mlauke/smartswitch/README.md

# Sonnen SmartSwitch
DIY sonnen battery controller based on ESP8266/ESP32 to drive a 3.3kW heater (Heißwasserspeicher-Einbauheizung) and integrates with the local hot water system.

## Features
- accesses the local hot water system (boiler system) via **LPB** to get the hot water system data - e.g. hot water temparature
- calculate battery capacity and surplus from **solar forecast** to optimize the self consumption
- local web interface to customize system parameters

## UI
<a href="public/ui_full.png">
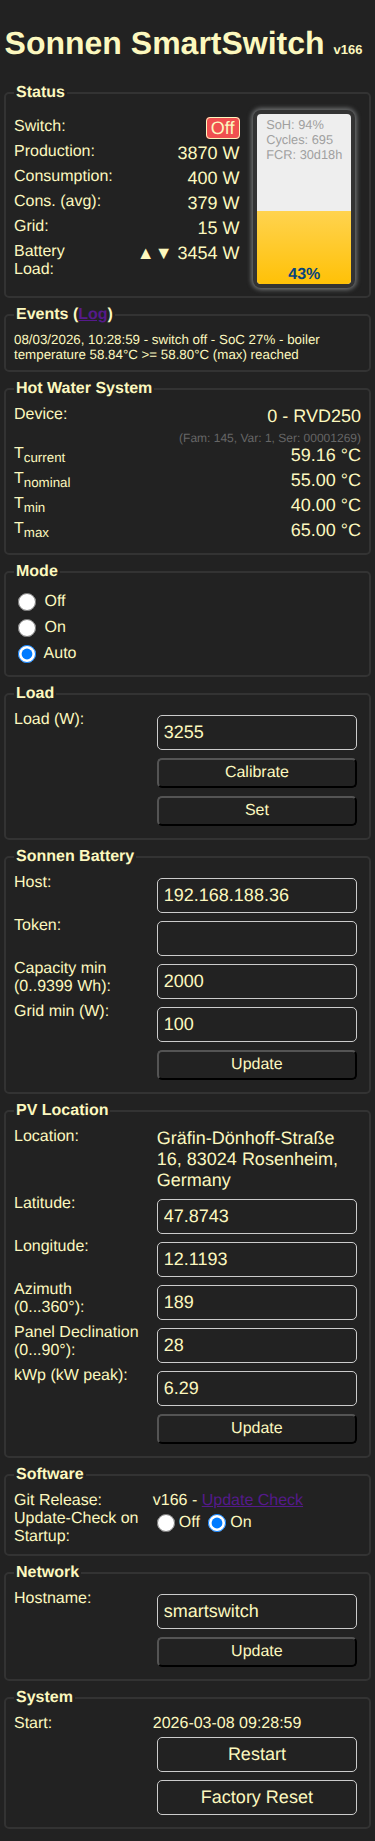
[picture p1: public/ui_full.png]
Sonnen SmartSwitch UI, best viewed in dark mode

</a>

## Software / Releases
the software supports ESP8266 and ESP32 modules, which can be build for the appropriate target platform. releases can be found at https://github.com/mlauke/smartswitch/releases/

### Build
Install uv (https://docs.astral.sh/uv/concepts/tools/) and run proceed to source folder
```bash
cd smartswitch.espxx
# run tests
uv run pio test -e native
# run build
uv run pio run -e esp32 -e esp8266
# run check for outdated packages
uv run pio pkg outdated
```

## Hardware
the reference implementation (at my home) uses the following components
- Heater - https://www.austria-email.at/produkte/zubehoer/elektro-einbauheizung/reu-18-33/
- Hot Water Tank - https://www.austria-email.at/produkte/indirekt-beheizte-speicher/standspeicher/standspeicher-hr/hr-160/
- Sonnen Battery https://sonnen.de/stromspeicher/sonnenbatterie-10/
- Boiler System - Siemens RVD250 attached and connected to the ESP controller via the Local Process Bus (LPB)
- ESP8266/ESP32 controller modules
- ArduiBox housing https://www.az-delivery.de/en/products/arduibox-nodemcu-hutschienen-montage-und-anschluss-set
- DIN Rail Power supply +12V
- AC mains Triac cicuit to drive a 1NO Relay
- 1NO Relay (Schütz) https://www.reichelt.de/de/de/shop/produkt/schaltrelais_1_s_230_v_ac_16_a-155592

### Schematics

The schematics and pcb is drawn with KiCad. The pcb uses a special layout which exactly matches the usable part of the ArduiBox's circuit board. KiCad files can be found <a href="kicad/">here.</a>

<p align="center">
<a href="public/sch.png">
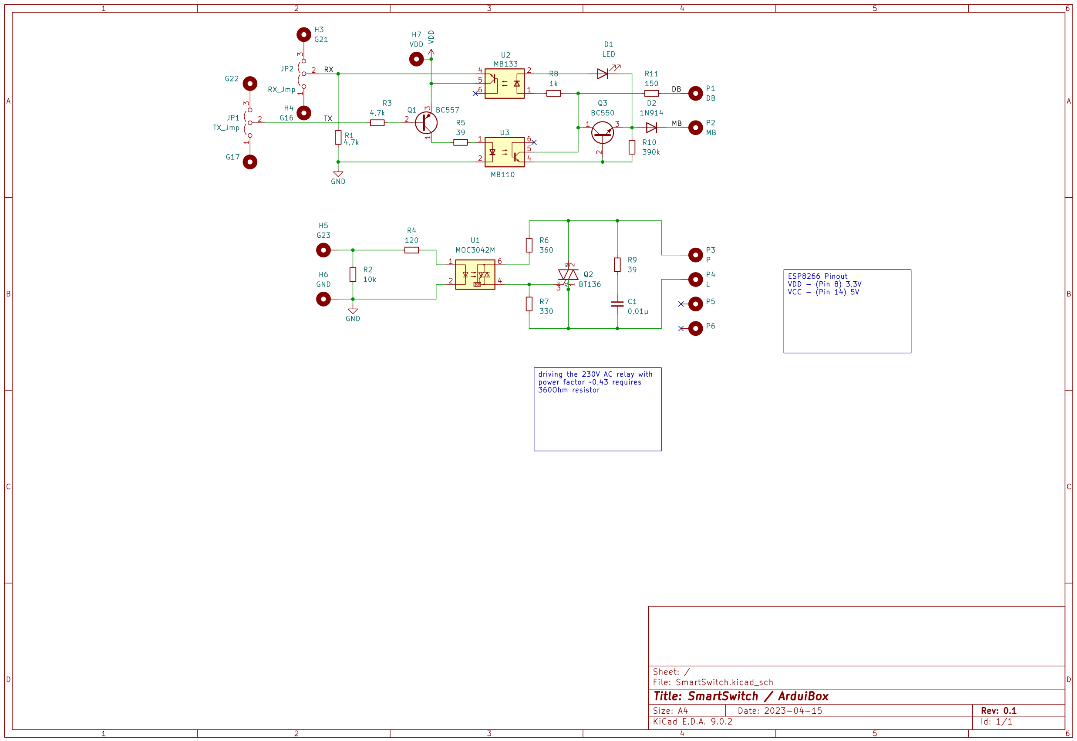
[picture p2: public/sch.png]

</a>
<a href="public/pcb_3d.png">
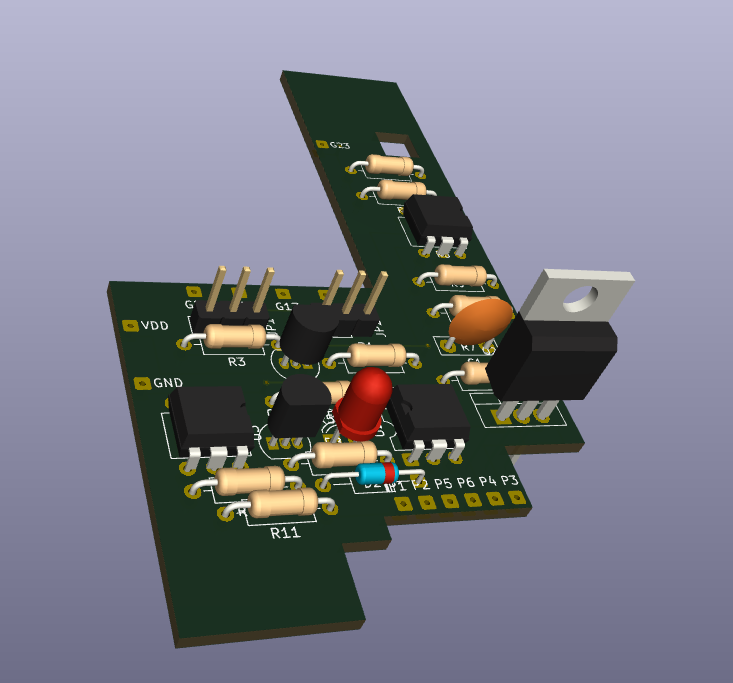
[picture p3: public/pcb_3d.png]

</a>
</p>

### Housing

<details open align="center">
<summary>Housing</summary>
<a href="public/sss_arduibox.png">
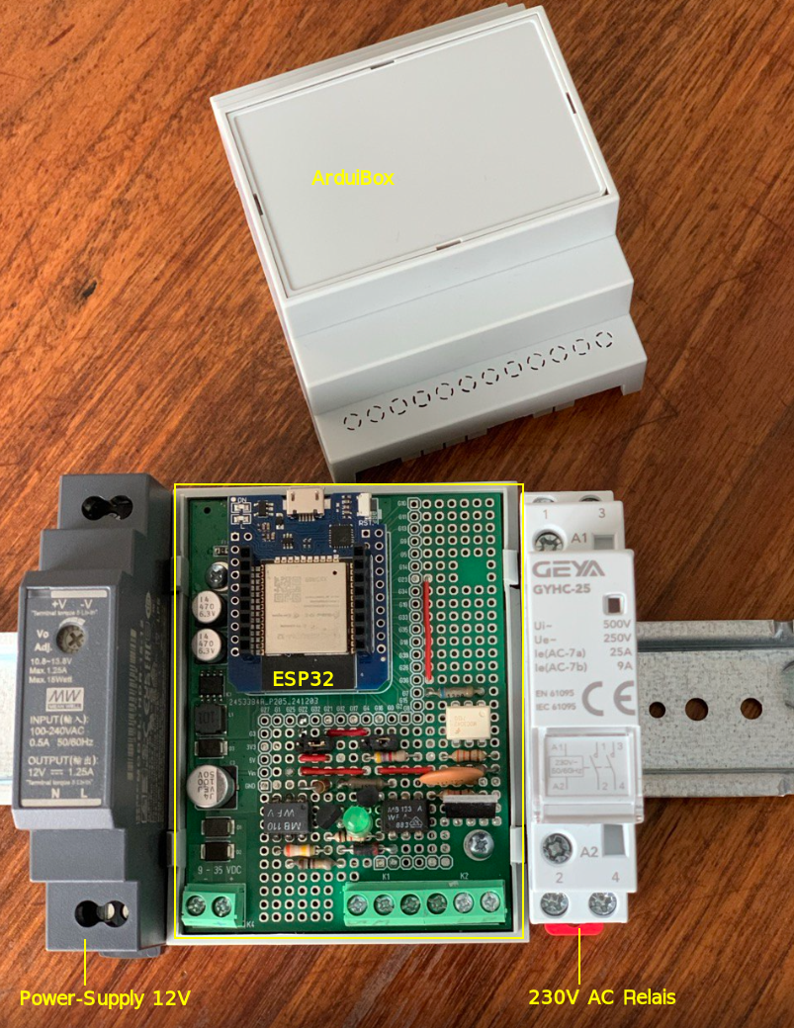
[picture p4: public/sss_arduibox.png]
Sonnen SmartSwitch wihin ArduiBox, Power Supply and Relais (Schütz) mounted on DIN rail

</a>
<!--a href="public/sss_fusebox_big.png">
<img alt="Sonnen SmartSwitch installed in fuse box" src="public/sss_fusebox_big.png" width="30%"/-->
<a href="public/sss_fusebox.png">
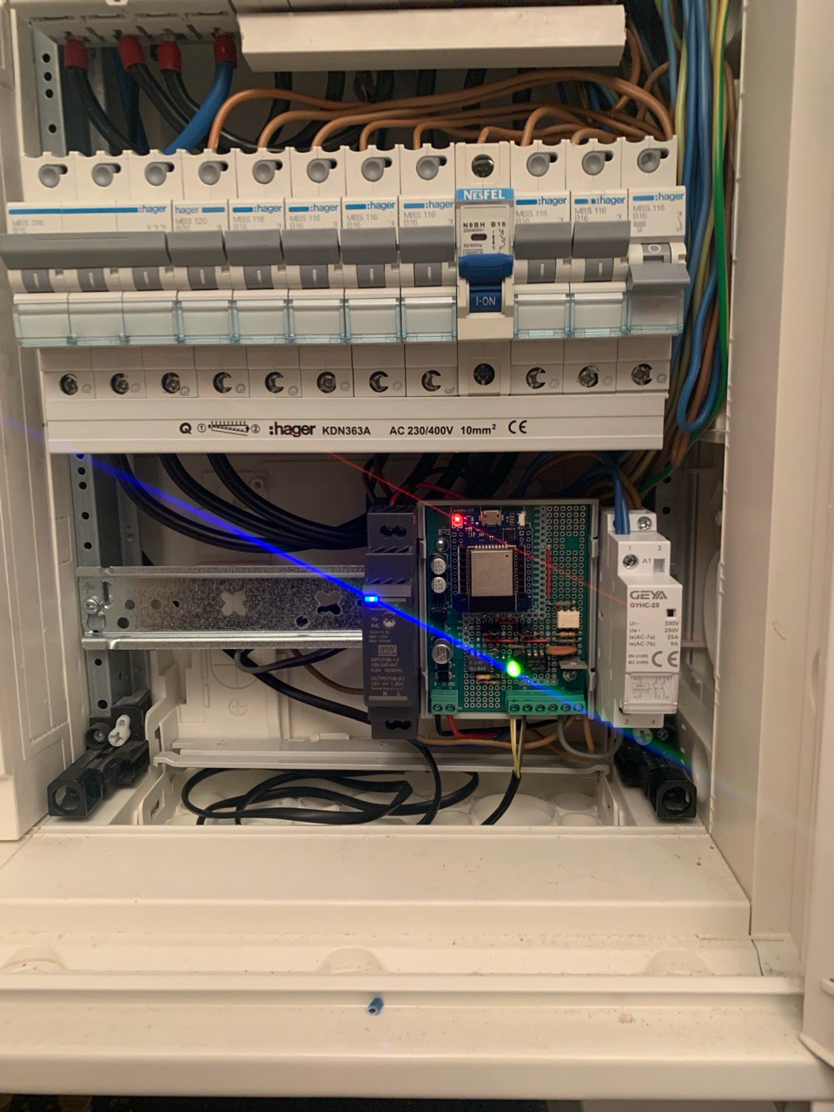
[picture p5: public/sss_fusebox.png]
Sonnen SmartSwitch installed in fuse box

</a>
</details>

### Thoughts
#### Why not using a TRIAC only solution?
Although Triacs have very low Rs_on values in nowadays, they become very hot depending on the load to drive. Using a 3.3kW heater will require a big heatsink as can be seen in the calculation below.

```bash
Pmax = (Tj,max - Tamb,max) / Rth

I = P / U = 3300W / 230 V = 14,35A
Rs_on (BTA25) = 0,16 Ohm
P_loss = U * I = Rs_on * I * I
P_loss = 0,16 Ohm * (14,35 A)²
P_loss = 32,95W

R_max = (T_max - T_env) / P_loss
R_max = (120°C - 40°C) / 33W
R_max = 2,42K/W
R_heatsink = R_max - R_jc = 2,42K/W - 1,7K/W
R_heatsink = 0,7K/W !!!
```

... heatsink with <=0,7K/W makes no sense, because we will waste too much power wasted just for heating the environment and maybe would "blow up" the overall system design in terms of size and housing the components.
therefore i decided to use a triac as switching device for a simple NO1 relais ("Schütz") which in turn will drive the load. the NO1 relais can directly placed next to the arduino case on our din rail.

#### Why not using a SSR?
as mentioned above, a SSR which can drive the 3,3kW load will become very hot if the load is switched on for longer heating periods. too hot to put the SSR together with the ESP controller board on a din rail inside of my houses fuse box.

## Vision
- hardware
  - build a GaN (HEMT) AC Power Converter to dynamically control the "waste" of surplus power based on a bidirection GaN (HEMT) device => https://www.infineon.com/products/power/gallium-nitride/gan-bidirectional-switches/high-voltage-gan-bidirectional-switches e.g. https://www.infineon.com/part/IGLT65R055B2
