mlauke/smartswitch/public/sss_fusebox_big.png

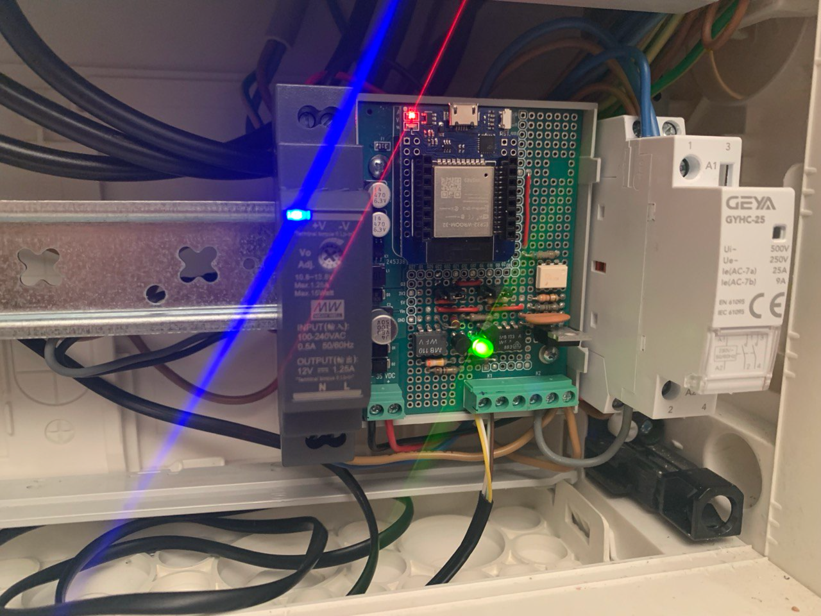
public/sss_fusebox_big.png
