mlauke/smartswitch/public/ui_top.png

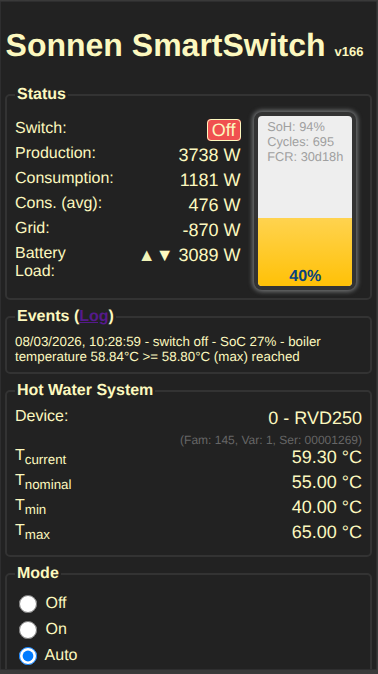
public/ui_top.png
