mlauke/smartswitch/ltspice/LPB_Adapter.asc

D1: diode
D2: LED
Q1: npn; BC547C
Q2: pnp; BC557C
R1: res; 39
R2: res; 4.7k
R3: res; 1k
R5: res; 390k
R7: res; 4.7k
R8: res; 150
U2: PC817A
U4: PC817A
V1: voltage; PULSE(3.3 0 0.05 0 0 0.005 0.02 20)
V2: voltage; 15.5
V3: voltage; 3.3V
Named nets: 0, TX, RX, VCC, DB, MB
.tran 0 200m 0 10u
