mlauke/smartswitch/kicad/SmartSwitch.kicad_pcb

## KiCad design kicad/SmartSwitch.kicad_pcb (2026-03-17)

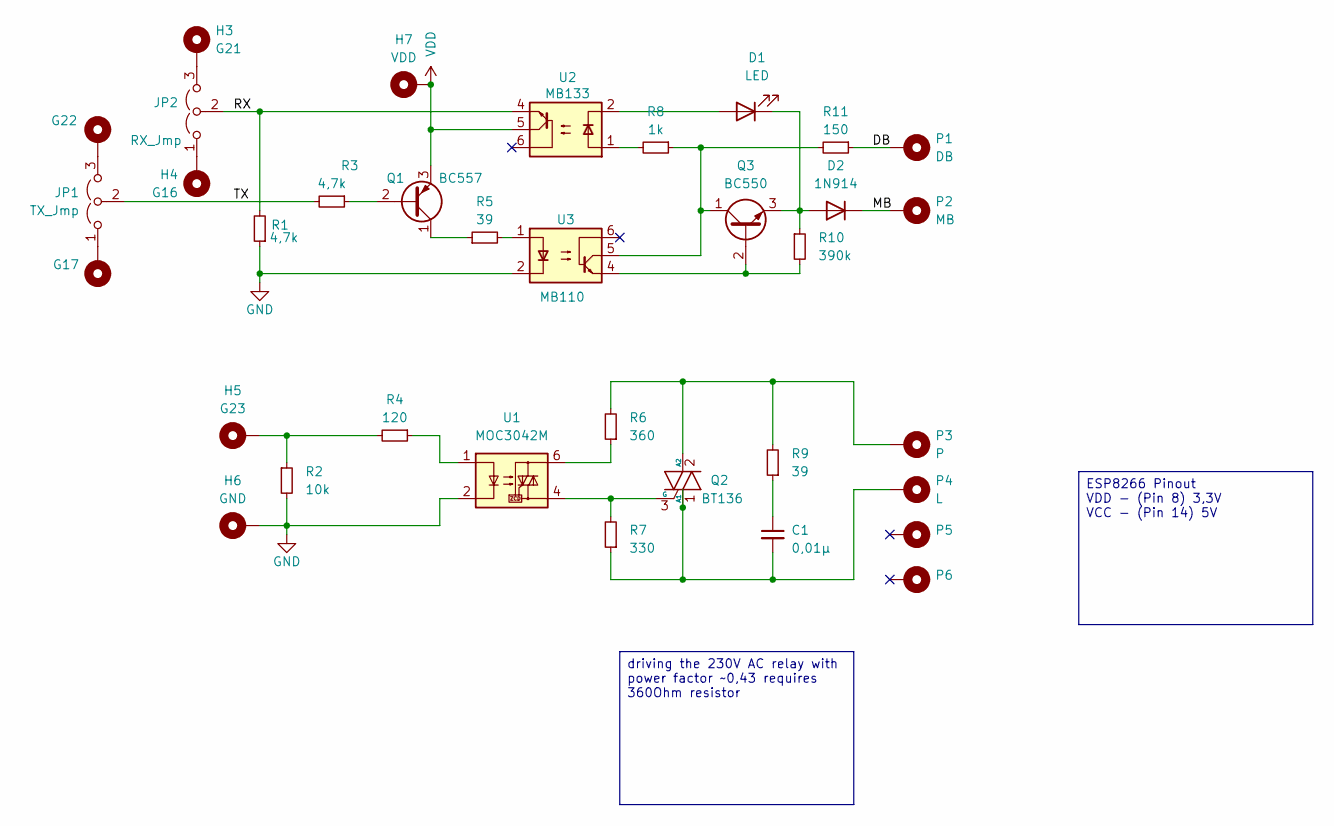
[picture p8: schematic SmartSwitch.kicad_sch, SmartSwitch / ArduiBox]

Parts:
C1: 0,01µ; C_Disc_D7.5mm_W2.5mm_P5.00mm
D1: LED; LED_D4.0mm
D2: 1N914; D_DO-35_SOD27_P10.16mm_Horizontal
H1: G22; SolderWire-0.1sqmm_1x01_D0.4mm_OD1mm
H2: G17; SolderWire-0.1sqmm_1x01_D0.4mm_OD1mm
H3: G21; SolderWire-0.1sqmm_1x01_D0.4mm_OD1mm
H4: G16; SolderWire-0.1sqmm_1x01_D0.4mm_OD1mm
H5: G23; SolderWire-0.1sqmm_1x01_D0.4mm_OD1mm
H6: GND; SolderWire-0.1sqmm_1x01_D0.4mm_OD1mm
H7: VDD; SolderWire-0.1sqmm_1x01_D0.4mm_OD1mm
JP1: TX_Jmp; PinHeader_1x03_P2.54mm_Vertical
JP2: RX_Jmp; PinHeader_1x03_P2.54mm_Vertical
P1: DB; SolderWire-0.1sqmm_1x01_D0.4mm_OD1mm
P2: MB; SolderWire-0.1sqmm_1x01_D0.4mm_OD1mm
P3: P; SolderWire-0.1sqmm_1x01_D0.4mm_OD1mm
P4: L; SolderWire-0.1sqmm_1x01_D0.4mm_OD1mm
P5, P6: SolderWire-0.1sqmm_1x01_D0.4mm_OD1mm
Q1: BC557; TO-92_Inline
Q2: BT136; TO-220-3_Vertical
Q3: BC550; TO-92_Inline
R1, R3: 4,7k; R_Axial_DIN0207_L6.3mm_D2.5mm_P10.16mm_Horizontal
R2: 10k; R_Axial_DIN0207_L6.3mm_D2.5mm_P10.16mm_Horizontal
R4: 120; R_Axial_DIN0207_L6.3mm_D2.5mm_P10.16mm_Horizontal
R5, R9: 39; R_Axial_DIN0207_L6.3mm_D2.5mm_P10.16mm_Horizontal
R6: 360; R_Axial_DIN0207_L6.3mm_D2.5mm_P10.16mm_Horizontal
R7: 330; R_Axial_DIN0207_L6.3mm_D2.5mm_P10.16mm_Horizontal
R8: 1k; R_Axial_DIN0207_L6.3mm_D2.5mm_P10.16mm_Horizontal
R10: 390k; R_Axial_DIN0207_L6.3mm_D2.5mm_P10.16mm_Horizontal
R11: 150; R_Axial_DIN0207_L6.3mm_D2.5mm_P10.16mm_Horizontal
U1: MOC3042M; DIP-6_W7.62mm
U2: MB133; DIP-6_W7.62mm
U3: MB110; DIP-6_W7.62mm

Connections:
/DB: P1.1, R11.1
/MB: D2.1 (K), P2.1
/RX: JP2.2 (C), R1.2, U2.4
/TX: JP1.2 (C), R3.2
GND: H6.1, R1.1, R2.2, U1.2, U3.2
unnamed: C1.1, R9.1
unnamed: D1.2 (A), U2.2
unnamed: D1.1 (K), D2.2 (A), Q3.3 (E), R10.1
unnamed: H5.1, R2.1, R4.2
unnamed: H2.1, JP1.1 (A)
unnamed: H1.1, JP1.3 (B)
unnamed: H4.1, JP2.1 (A)
unnamed: H3.1, JP2.3 (B)
unnamed: Q1.2 (B), R3.1
unnamed: Q1.1 (C), R5.1
unnamed: C1.2, P4.1, Q2.1 (A1), R7.1
unnamed: P3.1, Q2.2 (A2), R6.2, R9.2
unnamed: Q2.3 (G), R7.2, U1.4
unnamed: Q3.2 (B), R10.2, U3.4
unnamed: Q3.1 (C), R8.1, R11.2, U3.5
unnamed: R4.1, U1.1
unnamed: R5.2, U3.1
unnamed: R6.1, U1.6
unnamed: R8.2, U2.1
VDD: H7.1, Q1.3 (E), U2.5

Notes on the sheet:
ESP8266 Pinout VDD - (Pin 8) 3,3V VCC - (Pin 14) 5V
driving the 230V AC relay with power factor ~0,43 requires 360Ohm resistor

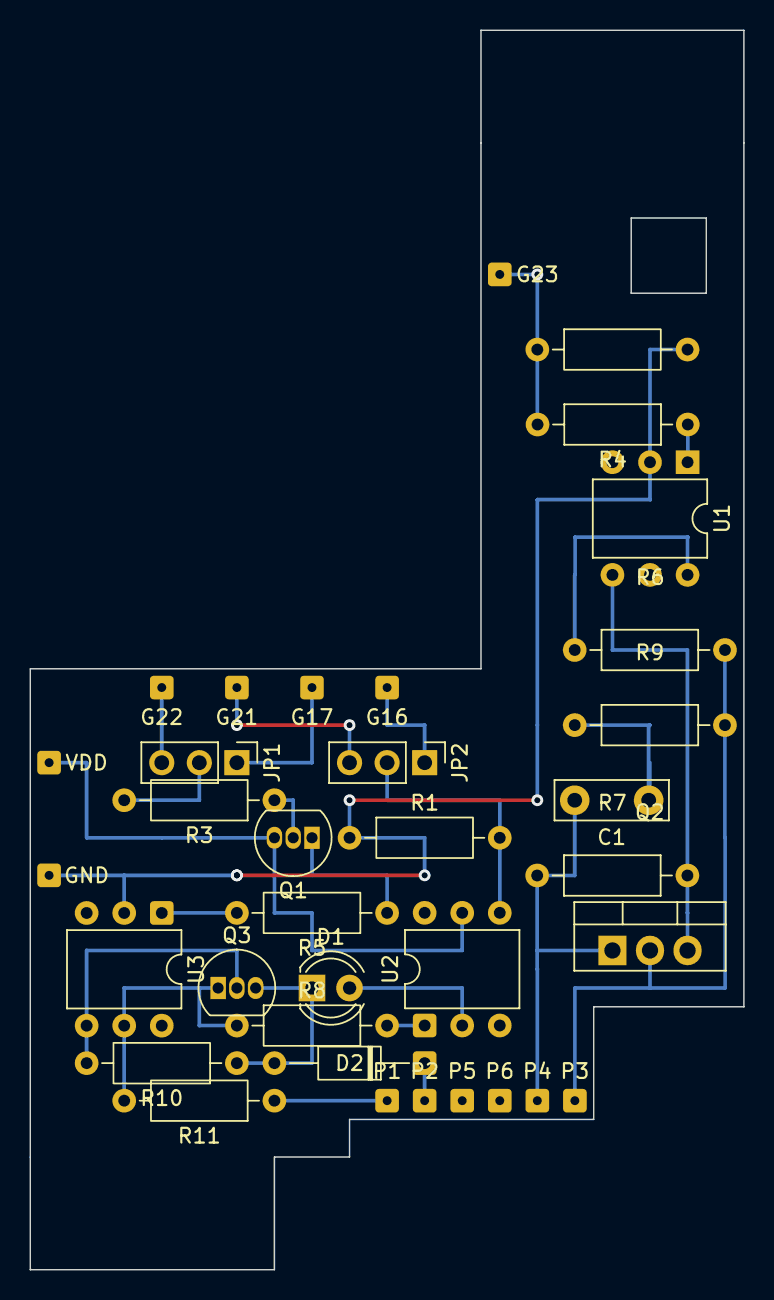
[picture p9: board SmartSwitch.kicad_pcb from above]

Board: 2 copper layers, 48.3 x 83.8 mm, 35 parts (0 on the bottom side), 25 nets.
