mlauke/smartswitch/smartswitch.espxx/src/main.ino

// MIT License
//
// Copyright (c) 2024 Marko Lauke
//
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
// THE SOFTWARE IS PROVIDED "AS IS", WITHOUT WARRANTY OF ANY KIND, EXPRESS OR
// IMPLIED, INCLUDING BUT NOT LIMITED TO THE WARRANTIES OF MERCHANTABILITY,
// FITNESS FOR A PARTICULAR PURPOSE AND NONINFRINGEMENT. IN NO EVENT SHALL THE
// AUTHORS OR COPYRIGHT HOLDERS BE LIABLE FOR ANY CLAIM, DAMAGES OR OTHER
// LIABILITY, WHETHER IN AN ACTION OF CONTRACT, TORT OR OTHERWISE, ARISING FROM,
// OUT OF OR IN CONNECTION WITH THE SOFTWARE OR THE USE OR OTHER DEALINGS IN THE
// SOFTWARE.
#include <Arduino.h>
#include <ArduinoJson.h>
#include <LittleFS.h>
#include <Ticker.h>
#include <WiFiClient.h>
#include <WiFiClientSecure.h>
#include <WiFiManager.h>

// echo -e "const char index_html[] PROGMEM = { $(gzip -9 -c nginx/index.html | hexdump -v -e '1/1 "0x%02X, "') };" > src/smartswitch.esp8266/index_html.h && \
// echo -e "const char app_js[] PROGMEM = { $(gzip -9 -c nginx/app.js | hexdump -v -e '1/1 "0x%02X, "') };" > src/smartswitch.esp8266/app_js.h && \
// echo "const char app_css[] PROGMEM = { $(gzip -9 -c nginx/app.css | hexdump -v -e '1/1 "0x%02X, "') };" > src/smartswitch.esp8266/app_css.h

#include "GithubOTA.h"
#include "RestClient.h"
#include "JsonFields.h"
#include "SonnenApi.h"
#include "LPB.h"
#include "Util.h"

#include "app_js.h"
#include "app_css.h"
#include "app_icon.h"
#include "index_html.h"

#ifdef ESP32
#include <ESPmDNS.h>
#include <WiFi.h>
#include <WebServer.h>
#include <esp_task_wdt.h>
#include <freertos/FreeRTOS.h>
#include <freertos/task.h>

#elif ESP8266
#include <ESP8266HTTPClient.h>
#include <ESP8266WiFi.h>
#include <ESP8266WebServer.h>
#include <ESP8266mDNS.h>
#include <ESP8266httpUpdate.h>
#endif

#include "SmartSwitch.h"
#include "Logic.h"
#include "debug.h"

#ifdef ESP32
static WebServer server(WEBSERVER_PORT);
#elif ESP8266
static ESP8266WebServer server(WEBSERVER_PORT);
#endif

volatile bool doUpdateFlag = false;

LPB *lpb;
WiFiManager wifiManager;
Ticker timer;
SystemState systemState;
SystemConfig config;
bool saveConfigFile = false;
static SwitchStateId currentState = STATE_OFF;

void saveConfigCallback()
{
  saveConfigFile = true;
}

// labels and the pointer array both in flash - on esp8266 plain .rodata would land in dram
static const char PHASE_LABEL_SERVER[] PROGMEM = "web server";
static const char PHASE_LABEL_CYCLE[] PROGMEM = "update cycle";
static const char PHASE_LABEL_WIFI[] PROGMEM = "wifi reconnect";
static const char PHASE_LABEL_BATTERY[] PROGMEM = "battery api";
static const char PHASE_LABEL_FORECAST[] PROGMEM = "pv forecast";
static const char PHASE_LABEL_BOILER[] PROGMEM = "boiler transfer";
static const char PHASE_LABEL_UPDATE[] PROGMEM = "update check";

static const char *const WatchdogPhaseLabel[PHASE_COUNT] PROGMEM = {
    NULL, PHASE_LABEL_SERVER, PHASE_LABEL_CYCLE, PHASE_LABEL_WIFI,
    PHASE_LABEL_BATTERY, PHASE_LABEL_FORECAST, PHASE_LABEL_BOILER, PHASE_LABEL_UPDATE};

// survives watchdog, panic and external reset - only a power loss clears it, hence the magic
static RESET_PERSIST_ATTR uint32_t watchdogPhaseMagic;
static RESET_PERSIST_ATTR uint8_t watchdogPhase;

// every remote call may block until its timeout, so the watchdog is fed before each of them.
// the phase is kept in memory that survives a reset, so a reboot can name what was blocking
static void feedWatchdog(WatchdogPhase phase)
{
  watchdogPhaseMagic = WATCHDOG_PHASE_MAGIC;
  watchdogPhase = phase;

#ifdef ESP32
  esp_task_wdt_reset();
#elif ESP8266
  ESP.wdtFeed();
#endif
}

// names the phase the reset hit, empty if the marker did not survive or the restart was planned
static String lastWatchdogPhase()
{
  if (watchdogPhaseMagic != WATCHDOG_PHASE_MAGIC || watchdogPhase == PHASE_IDLE || watchdogPhase >= PHASE_COUNT)
  {
    return String();
  }
  return String(F(" (")) + FPSTR((const char *)pgm_read_ptr(&WatchdogPhaseLabel[watchdogPhase])) + F(")");
}

void start()
{
  server.begin(); // Actually start the server
  DEBUGLN("HTTP server started");

  uint8_t retries = isDevMode() ? 1 : LPB_RETRIES;
  if (!lpb->enableInterface(retries))
  {
    putBoilerError(String("LPB: No device found after ") + retries + " retries!");
  }
#ifdef ESP32
  esp_task_wdt_init(WDT_TIMEOUT_S, true); // panic handler reboots, the ssr input is high-z until setup() drives it
  esp_task_wdt_add(NULL);                 // watch the task running loop()
#elif ESP8266
  ESP.wdtEnable(20000);
#endif
}

// the reset reason survives in hardware, it is the only trace a watchdog or panic leaves
static String resetReason()
{
#ifdef ESP32
  switch (esp_reset_reason())
  {
  case ESP_RST_POWERON:
    return F("power on");
  case ESP_RST_EXT:
    return F("external reset");
  case ESP_RST_SW:
    return F("software restart");
  case ESP_RST_PANIC:
    return F("panic / exception");
  case ESP_RST_INT_WDT:
    return F("interrupt watchdog timeout");
  case ESP_RST_TASK_WDT:
    return F("task watchdog timeout");
  case ESP_RST_WDT:
    return F("watchdog timeout");
  case ESP_RST_BROWNOUT:
    return F("brownout");
  default:
    return F("unknown");
  }
#elif defined(ESP8266)
  return ESP.getResetReason();
#endif
}

static void configureSystemTime()
{
  configTime(0, 0, NTP_SERVER_PRIMARY, NTP_SERVER_SECONDARY);
  DEBUGLN("systime configured.");
}

// tls certificate validation rejects every certificate while the clock is still at
// 1970, so the update check must not run before ntp has answered
static void waitForSystemTime()
{
  for (uint16_t waited = 0; waited < NTP_SYNC_TIMEOUT_MS && time(NULL) < NTP_SYNC_EPOCH; waited += NTP_SYNC_POLL_MS)
  {
    delay(NTP_SYNC_POLL_MS);
  }
  DEBUGF("systime: %s\n", toDate((uint32_t)time(NULL)));
}

void setup()
{
  configDefaults();
  systemDefaults();

  Serial.begin(SERIAL_BAUDRATE);

  pinMode(LED_BUILTIN, OUTPUT);
  pinMode(PIN_SSR, OUTPUT);
  updateSwitch(false);

  wifiManager.setSaveConfigCallback(saveConfigCallback);

  WiFiManagerParameter custom_hostname("hostname", "Hostname", config.hostname, CFG_SZ_HOSTNAME);
  wifiManager.addParameter(&custom_hostname);
  wifiManager.setConfigPortalTimeout(60);
  if (!wifiManager.autoConnect("SmartSwitchAP"))
  {
    DEBUGLN("Failed to connect, restarting...");
    restart();
  }

  lpb = new LPB(PIN_LPB_RX, PIN_LPB_TX, LPB_ADDR_SELF, LPB_ADDR_DEST);

  DEBUGLN("Mounting FS...");
  if (!LittleFS.begin())
  {
    DEBUGLN("Failed to mount FS. Attempting to format...");
    LittleFS.format();
    DEBUGLN(" done.");
  }
  if (!loadConfig())
  {
    DEBUGLN("Error loading config");
    saveConfig();
  }

  currentState = stateForMode(config.mode);

  if (saveConfigFile)
  {
    String lcHostname = String(custom_hostname.getValue());
    lcHostname.toLowerCase();
    setConfigStr(config, hostname, lcHostname.c_str());
    if (!saveConfig())
    {
      DEBUGLN("Error saving config");
    }
  }

  WiFi.setHostname(config.hostname);
  MDNS.begin(config.hostname);

  timer.attach_ms(SYSTEM_UPDATE_INTERVAL_MS, timerCallback);

  configureSystemTime();
  waitForSystemTime(); // a valid clock before the first entry is written

  loadEventLogIndex();
  putEvent(String(F("boot: ")) + resetReason() + lastWatchdogPhase());
  feedWatchdog(PHASE_IDLE); // consumed, the next reset starts from a clean marker

  if (config.update_startup)
  {
    handleGithubUpdate();
  }

  updateLocation();

  server.on("/", handleRoot);
  server.on("/favicon.ico", handleFavicon);
  server.on("/app.js", handleAppJs);
  server.on("/app.css", handleAppCss);
  server.on("/api/status", handleStatus);
  server.on("/api/data", handleData);
  server.on("/api/update", handleAPI);
  server.onNotFound(handleNotFound);
#if ESP8266
  server.keepAlive(false);
#endif
  start();

  /* HTTP Server auf Core 0 */
  // xTaskCreatePinnedToCore(
  //     httpTask,
  //     "HTTP",
  //     8192,
  //     NULL,
  //     1,
  //     NULL,
  //     0);
}

void timerCallback()
{
  doUpdateFlag = true;
}

void onOTABegin()
{
  server.close();

  if (timer.active())
    timer.detach();
  lpb->disableInterface();
#ifdef ESP32
  esp_task_wdt_delete(NULL); // flashing keeps loop() busy far longer than the watchdog allows
#elif ESP8266
  ESP.wdtDisable();
#endif
  updateSwitch(false);
}

void onOTAEnd(bool success)
{
  if (success)
  {
    DEBUGLN("OTA update finished successfully!");
    return;
  }
  DEBUGLN("There was an error during OTA update!");
  start(); // restart server again
}

void systemDefaults()
{
  systemState.start_ts = 0;
  systemState.pv_forecast_ts = 0;
  memset(systemState.pv_forecast_ts_wh, 0, sizeof(systemState.pv_forecast_ts_wh));
  systemState.inv_max_w = -1;
  systemState.utc_offset = -1;
  systemState.switchEnabled = false;
  systemState.skipUpdateCountSysten = 0;
}

void configDefaults()
{ // init config struct with default values

#ifdef ESP32
  setConfigStr(config, hostname, WiFi.getHostname());
#elif ESP8266
  setConfigStr(config, hostname, WiFi.hostname().c_str());
#endif
  setConfigStr(config, release_tag, RELEASE_TAG);
  config.sonnenHostname[0] = '\0';
  config.sonnenApiToken[0] = '\0';
  config.lon = 0.0;
  config.lat = 0.0;
  config.az = 0;    // default azimuth to 0 (south)
  config.dec = 30;  // default panel declination
  config.kWp = 1.0; // default kWp
  setConfigStr(config, tz, "Europe/Berlin");
  config.location[0] = '\0';
  config.loadPower_W = 1000; // initial assume 1kW
  config.bat_soc_min = 5;
  config.gridMin_W = GRID_PURCHASE_THRESHOLD_W;
  config.mode = SMODE_OFF; // initial set to off
  config.update_startup = false;

  config.version = 0;
}

static bool isDevMode()
{
  return strstr(config.hostname, "-dev") != NULL;
}

bool updateSolarForecast()
{
  static bool lastResult = false;

  long ms = millis();
  if (config.lat != 0.0 && config.lon != 0.0 && (systemState.pv_forecast_ts == 0 || (systemState.pv_forecast_ts + SOLAR_FORECAST_INTERVAL_MS) < ms))
  {

    RestClient restClient;
    JsonDocument json;

    String solarUrl = isDevMode() ? URL_SOLAR_FORECAST_DEV : URL_SOLAR_FORECAST;
    char url[160];
    // solar forecast api requires azimuth with -180 north, -90 east, 0 south, 90 west
    snprintf(url, sizeof(url), solarUrl.c_str(), config.lat, config.lon, config.dec, config.az - 180, config.kWp);

    feedWatchdog(PHASE_FORECAST);
    if ((lastResult = restClient.get(String(url), json, NULL)))
    {
      serializeJsonPretty(json, Serial);
      memset(systemState.pv_forecast_ts_wh, 0, sizeof(systemState.pv_forecast_ts_wh));
      uint8_t i = 0;
      for (JsonPair entry : json[F("result")].as<JsonObject>())
      {
        uint32_t ts = strtoul(entry.key().c_str(), NULL, 10);
        uint32_t wh = entry.value().as<uint32_t>();
        if (i < SOLAR_FORECAST_HOURS)
        {
          systemState.pv_forecast_ts_wh[i][0] = ts;
          systemState.pv_forecast_ts_wh[i][1] = wh;
          i++;
        }
        else
        {
          putEvent(String(F("WARN: updateSolarForecast overflow ")) + i);
          break;
        }
      }
      setConfigStr(config, location, json[F("message")][F("info")][F("place")].as<const char *>());

      clearLocationError();
    }
    else
    {
      putLocationError(String(F("WARN solar forecast ")) + restClient.lastError());
    }
    systemState.pv_forecast_ts = restClient.lastResponseCode() > 0 ? ms : 0;
  }
  return lastResult;
}

void updateLocation()
{
  if (config.lat == 0.0 && config.lon == 0.0)
  {
    RestClient restClient;
    JsonDocument json;

    if ((saveConfigFile = restClient.get(URL_LOCATION, json, NULL)))
    {
      config.lon = json[F("lon")].as<double>();
      config.lat = json[F("lat")].as<double>();
      snprintf_P(config.location, CFG_SZ_LOCATION, PSTR("%s %s"), json[F("zip")].as<const char *>(), json[F("city")].as<const char *>());
      setConfigStr(config, tz, json[F("timezone")]);
      DEBUGF("Location: %f/%f - tz: %s loc: %s\n", config.lon, config.lat, config.tz, config.location);
    }
  }
}

void cacheControlHeader(bool cache)
{
  if (cache)
    server.sendHeader(F("cache-control"), F("max-age=31536000, must-revalidate"));
  else
    server.sendHeader(F("cache-control"), F("no-cache"));
}

void commonHeader()
{
  server.sendHeader(F("content-encoding"), F("gzip"));
  cacheControlHeader(true);
}

void handleFavicon()
{
  cacheControlHeader(true);
  server.send_P(200, PSTR("image/x-icon"), app_icon, sizeof(app_icon));
}

void handleAppJs()
{
  commonHeader();
  server.send_P(200, PSTR("text/javascript"), app_js, sizeof(app_js));
}

void handleAppCss()
{
  commonHeader();
  server.send_P(200, PSTR("text/css;charset=utf-8"), app_css, sizeof(app_css));
}

void handleRoot()
{
  commonHeader();
  server.send_P(200, PSTR("text/html;charset=utf-8"), index_html, sizeof(index_html));
}

void jsonToConfig(JsonDocument &json)
{
  config.mode = (SwitchMode)json[F("mode")].as<uint8_t>();
  setConfigStr(config, release_tag, json[F("release_tag")]);

  config.update_startup = json[F("update_startup")];

  setConfigStr(config, hostname, json[F("hostname")]);

  setConfigStr(config, sonnenHostname, json[F("sn_host")]);
  setConfigStr(config, sonnenApiToken, json[F("sn_token")]);
  config.gridMin_W = json[F("sn_grdmin")].as<uint16_t>();
  config.loadPower_W = json[F("sn_loadpower")].as<uint16_t>();
  config.bat_soc_min = json[F("sn_soc_min")].as<uint8_t>();

  config.lon = json[F("lc_lon")].as<float>();
  config.lat = json[F("lc_lat")].as<float>();
  config.kWp = json[F("lc_kWp")].as<float>();
  config.az = json[F("lc_az")].as<uint16_t>();
  config.dec = json[F("lc_dec")].as<uint16_t>();

  setConfigStr(config, location, json[F("loc")]);
  setConfigStr(config, tz, json[F("tz")]);

  JsonArray dayStats = json[F("cons_stats")].as<JsonArray>();
  if (!dayStats.isNull())
  {
    for (int d = 0; d < 7 && d < (int)dayStats.size(); d++)
    {
      JsonArray hourStats = dayStats[d].as<JsonArray>();
      for (int h = 0; h < 24 && h < (int)hourStats.size(); h++)
        config.cons_stats_Wh[d][h] = hourStats[h].as<uint16_t>();
    }
  }

  config.version = json[F("version")].as<uint16_t>();
}

void configToJson(JsonDocument &json, bool confidential)
{
  json[F("mode")] = (uint8_t)config.mode;
  json[F("release_tag")] = config.release_tag;

  json[F("update_startup")] = config.update_startup;

  json[F("hostname")] = config.hostname;

  json[F("sn_host")] = config.sonnenHostname;
  if (!confidential)
  {
    json[F("sn_token")] = config.sonnenApiToken;
  }
  json[F("sn_grdmin")] = config.gridMin_W;
  json[F("sn_loadpower")] = config.loadPower_W;
  json[F("sn_soc_min")] = config.bat_soc_min;

  json[F("lc_lon")] = config.lon;
  json[F("lc_lat")] = config.lat;
  json[F("lc_kWp")] = config.kWp;
  json[F("lc_az")] = config.az;
  json[F("lc_dec")] = config.dec;

  json[F("loc")] = config.location;
  json[F("tz")] = config.tz;

  JsonArray dayStats = json[F("cons_stats")].to<JsonArray>();
  for (int d = 0; d < 7; d++)
  {
    JsonArray hourStats = dayStats.add<JsonArray>();
    for (int h = 0; h < 24; h++)
      hourStats.add(config.cons_stats_Wh[d][h]);
  }

  json[F("version")] = config.version;
}

void sendJson(String from, JsonDocument &json)
{
  String jsonString;

  serializeJsonPretty(json, jsonString);
  DEBUGF("%s - json %s\n", from.c_str(), jsonString.c_str());

  cacheControlHeader(false);
  server.send(200, F("application/json"), jsonString);
}

void addLog(JsonArray &array, logEntry &log)
{
  if (strlen(log.msg))
  {
    JsonObject e = array.add<JsonObject>();
    e[F("ts")] = log.ts;
    e[F("msg")] = log.msg;
  }
}

void handleData()
{
  JsonDocument json;

  configToJson(json, true);
  json[F("start_ts")] = toLocalDate(&systemState, systemState.start_ts);
  json[F("ca_store")] = caTrustStoreState();

  JsonArray forecast = json[F("pv_forecast")].to<JsonArray>();
  for (int i = 0; i < SOLAR_FORECAST_HOURS; i++)
  {
    if (systemState.pv_forecast_ts_wh[i][0] == 0)
      break;
    JsonArray entry = forecast.add<JsonArray>();
    entry.add(systemState.pv_forecast_ts_wh[i][0]); // Unix ts (s)
    entry.add(systemState.pv_forecast_ts_wh[i][1]); // Wh
  }

  sendJson("data", json);
}

// api/status
void handleStatus()
{
  JsonDocument json;

  json[F("cons_w")] = systemState.cons_W;
  json[F("cons_avg_w")] = systemState.cons_avg_W;
  json[F("prod")] = systemState.prod_W;
  json[F("grid")] = systemState.gridFeedIn_W;
  json[F("usoc")] = systemState.usoc;
  json[F("chrg")] = systemState.charge;
  json[F("pac_total_w")] = systemState.pac_total_W * -1; // invert - positive means discharge, we invert for display
  json[F("switch")] = systemState.switchEnabled;
  json[F("sn_cap_max")] = systemState.cap_bat_max_Wh;
  json[F("sn_cycles")] = systemState.bat_cycles;
  json[F("sn_cap_soh")] = systemState.cap_bat_soh;
  char buf[16];
  json[F("sn_fchrg_ts")] = format_duration(systemState.fullChargeRequestIn, buf, sizeof(buf));

  char dev_id[40] = "n.a.";
  char dev_nfo[40] = "";
  device_map *device = lpb->getDestDevice();
  if (device != NULL)
  {
    snprintf_P(dev_id, sizeof(dev_id), PSTR("%d - %s"), device->dev_id, device->name);
    snprintf_P(dev_nfo, sizeof(dev_nfo), PSTR("(Fam: %d, Var: %d, Ser: %08X)"), device->dev_fam, device->dev_var, device->dev_serial);
  }
  json[F("bs_dev_id")] = dev_id;
  json[F("bs_dev_nfo")] = dev_nfo;
  json[F("bs_t_cur")] = String(systemState.boiler_T_cur);
  json[F("bs_t_max")] = String(systemState.boiler_T_max);
  json[F("bs_t_min")] = String(systemState.boiler_T_min);
  json[F("bs_t_nom")] = String(systemState.boiler_T_nom);

  JsonArray errors = json[F("errors")].to<JsonArray>();
  addLog(errors, systemState.error_bt);
  addLog(errors, systemState.error_bs);
  addLog(errors, systemState.error_lc);

  JsonArray events = json[F("events")].to<JsonArray>();
  addEventLog(events);

  json[F("version")] = config.version;

  sendJson("status", json);
}

void handleAPI()
{

  bool doRestart = false;

  if (server.hasArg(F("mode")))
  {
    config.mode = (SwitchMode)(server.arg(F("mode")).toInt() & 3);
    currentState = stateForMode(config.mode);
    DEBUGF("Mode: %d\n", config.mode);
    saveConfig();
  }
  else if (server.hasArg(F("calibrate")))
  {
    if (server.arg(F("calibrate")).equals(F("set")))
    {
      config.loadPower_W = MAX(0, server.arg(F("sn_loadpower")).toInt());
      saveConfig();
    }
    else
    {
      currentState = STATE_CALIBRATE;
    }
  }
  else if (server.hasArg(F("update_startup")))
  {
    config.update_startup = server.arg(F("update_startup")).toInt();
    DEBUGF("Enabled: %d\n", config.update_startup);
    saveConfig();
  }
  else if (server.hasArg(F("certs")))
  {
    updateTrustStore(server.hasArg(F("certs_reset")) ? String() : server.arg(F("certs")));
  }
  else if (server.hasArg(F("boiler")))
  {
    // ?
  }
  else if (server.hasArg(F("sonnen")))
  {
    setConfigStr(config, sonnenHostname, server.arg(F("sn_host")).c_str());
    String apiToken = server.arg(F("sn_token"));
    if (apiToken.length() > 0)
    {
      setConfigStr(config, sonnenApiToken, apiToken.c_str());
    }
    config.gridMin_W = MAX(50, MAX(0, server.arg(F("sn_grdmin")).toInt()));
    config.bat_soc_min = MIN(100, MAX(0, server.arg(F("sn_soc_min")).toInt()));
    saveConfig();
    systemState.skipUpdateCountSysten = 0;
  }
  else if (server.hasArg(F("location")))
  {
    config.lon = MAX(0, server.arg(F("lc_lon")).toDouble());
    config.lat = MAX(0, server.arg(F("lc_lat")).toDouble());
    config.kWp = MAX(0, server.arg(F("lc_kWp")).toDouble());
    config.az = MIN(360, MAX(0, server.arg(F("lc_az")).toInt()));
    config.dec = MIN(90, MAX(0, server.arg(F("lc_dec")).toInt()));
    systemState.pv_forecast_ts = 0; // force fetch new data
    setConfigStr(config, location, PSTR("Location will be updated..."));
    for (int d = 0; d < 7; d++)
      for (int h = 0; h < 24; h++)
        config.cons_stats_Wh[d][h] = 0;
    saveConfig();
  }
  else if (server.hasArg(F("hostname")))
  {
    setConfigStr(config, hostname, server.arg(F("hostname")).c_str());
    doRestart = saveConfig();
  }
  else if (server.hasArg(F("restart")))
  {
    doRestart = saveConfig();
  }
  else if (server.hasArg(F("reset")))
  {
    if (server.arg(F("reset")).toInt())
    {
      configDefaults();
      wifiManager.resetSettings(); // reset wifi settings
      doRestart = saveConfig();
    }
  }
  else if (server.hasArg(F("update")))
  {
    handleGithubUpdate();
    return;
  }

  server.sendHeader(F("location"), F("/"));
  server.send(303);
  server.client().flush();

  if (doRestart)
  {
    restart();
  }
}

void handleNotFound()
{
  server.send_P(404, PSTR("text/plain"), PSTR("404: Not found")); // Send HTTP status 404 (Not Found) when there's no handler for the URI in the request
}

void restart()
{
  server.close();
  watchdogPhase = PHASE_IDLE; // an intentional restart has no phase to report
  saveEventLogIndex(); // the stored size matches the file after a controlled restart
  LittleFS.end();
  ESP.restart();
}

String userAgent()
{
  return String(F("SmartSwitch v")) + config.release_tag;
}

const char STRING_HTML_UPDATE[] PROGMEM = "<html lang='en'><head><meta http-equiv='refresh' content='30;url=/'></head><body><h1>%s</h1><p>Redirect in 30s...</p></body></html>";

void sendUpdateStatus(int code, const char *status)
{
  char buffer[256];
  snprintf_P(buffer, sizeof(buffer), STRING_HTML_UPDATE, status);
  server.send(code, F("text/html;charset=utf-8"), buffer);
}

void handleGithubUpdate()
{
  GithubOTA gh_updater(UPDATE_HOST, UPDATE_URL, UPDATE_TYPE, UPDATE_FILENAME);

  feedWatchdog(PHASE_UPDATE); // the download itself unsubscribes the watchdog, see onOTABegin()
  if (!gh_updater.checkUpdate(config.release_tag))
  {
    if (server.client() && server.client().connected())
    {
      char msg[128];
      snprintf_P(msg, sizeof(msg), PSTR("Update failed: %s"), gh_updater.getUpdateStatus().c_str());
      sendUpdateStatus(404, msg);
    }
    return;
  }

  if (server.client() && server.client().connected())
  {
    char msg[128];
    snprintf_P(msg, sizeof(msg), PSTR("Update found: Going to install Release %s."), gh_updater.release_tag.c_str());
    sendUpdateStatus(200, msg);
  }
  if (gh_updater.doUpdate(userAgent(), &onOTABegin, &onOTAEnd))
  {
    setConfigStr(config, release_tag, gh_updater.release_tag.c_str());
    if (!saveConfig())
    {
      putEvent(String(F("error saving config with release tag ")) + gh_updater.release_tag);
    }
    else
    {
      DEBUGLN("config saved.");
      restart();
    }
  }
  else
  {
    putEvent(gh_updater.getUpdateStatus());
  }
}

// replaces the tls trust store used for OTA, empty content restores the firmware bundle
void updateTrustStore(const String &pem)
{
  if (pem.length() == 0)
  {
    resetCaTrustStore();
    putEvent(F("certificates reset to firmware bundle"));
    return;
  }
  const __FlashStringHelper *error = saveCaTrustStore(pem);
  putEvent(error == NULL ? String(F("certificates updated")) : String(F("certificates rejected - ")) + error);
}

void clearLocationError()
{
  systemState.error_lc.msg[0] = '\0';
}

void putLocationError(String event)
{
  putLog(systemState.error_lc, event.c_str());
}

void clearBatteryError()
{
  systemState.error_bt.msg[0] = '\0';
}

void putBatteryError(String event)
{
  putLog(systemState.error_bt, event.c_str());
}

void putBoilerError(String event)
{
  putLog(systemState.error_bs, event.c_str());
}

void clearBoilerError()
{
  systemState.error_bs.msg[0] = '\0';
}

// system time comes from the battery api, ntp fills the gap until the first successful poll
static uint32_t eventTimestamp()
{
  return systemState.ts > 0 ? systemState.ts : (uint32_t)time(NULL);
}

void putLog(logEntry &log, const char *event)
{
  snprintf(log.msg, sizeof(log.msg), "%s", event);
  log.ts = eventTimestamp();
  DEBUGF("log %u: %s\n", log.ts, event);
}

void putEvent(const char *event)
{
  logEntry log;
  putLog(log, event);
  appendEventLog(log);
}

void putEvent(String event)
{
  putEvent(event.c_str());
}

static bool updateBoilerData()
{

  static long long lastUpdateSeconds = 0;
  static long lastResult = false;

  long seconds = millis() / 1000;
  if (lastUpdateSeconds == 0 || seconds > lastUpdateSeconds + BOILER_UPDATE_INTERVAL_SECONDS)
  {
    lastUpdateSeconds = seconds;

    boiler_t boilerData;
    feedWatchdog(PHASE_BOILER); // the whole transfer runs inside the driver, this is the last chance to feed
    if ((lastResult = lpb->update(&boilerData, isDevMode())))
    {
      systemState.boiler_T_cur = boilerData.t_cur;
      systemState.boiler_T_nom = boilerData.t_nom;
      systemState.boiler_T_min = boilerData.t_min;
      systemState.boiler_T_max = boilerData.t_max;

      clearBoilerError();
    }
    else
    {
      putBoilerError(F("Could not update boiler data."));
    }
  }
  return lastResult; // no new data, so still ok
}

// maps the user configured switch mode to the matching runtime state
static SwitchStateId stateForMode(SwitchMode mode)
{
  switch (mode)
  {
  case SMODE_ON:
    return STATE_ON;
  case SMODE_AUTO:
    return STATE_AUTO;
  case SMODE_OFF:
  default:
    return STATE_OFF;
  }
}

static void handleOff(SystemStatus status)
{
  systemState.switchEnabled = false;
}

static void handleOn(SystemStatus status)
{
  systemState.switchEnabled = true;
}

static void handleAuto(SystemStatus status)
{
  char msg[96];
  bool desiredState = determineDesiredState(msg, sizeof(msg), &config, &systemState, status);
  if (systemState.switchEnabled != desiredState)
  {
    putEvent(String(desiredState ? F("on") : F("off")) + F(" - ") + msg);
  }
  systemState.switchEnabled = desiredState;

  DEBUGF("handleAuto() ts: %s (%u) usoc: %2d%% p/c: %d/%d (W) avg: %d (Wh) grid: %d (W) heater %d\n",
         toDate(systemState.ts), systemState.ts, systemState.usoc, systemState.prod_W,
         systemState.cons_W, systemState.cons_avg_W, systemState.gridFeedIn_W, systemState.switchEnabled);
}

static void handleCalibrate(SystemStatus status)
{
  static uint8_t cnt = CALIBRATE_LOOP_CNT;
  static uint16_t load_on[CALIBRATE_MEASURE];
  static uint16_t load_off[CALIBRATE_MEASURE];

  if (status != SystemStatus::Ok)
  {
    putEvent("invalid configuration, cannot calibrate load");
    currentState = stateForMode(config.mode); // back to normal operation
    return;
  }

  if (cnt == 0)
  {
    config.loadPower_W = MAX(0, (median_uint16(load_on, CALIBRATE_MEASURE) - median_uint16(load_off, CALIBRATE_MEASURE)));
    saveConfig();

    char event[64];
    snprintf_P(event, sizeof(event), PSTR("load calibrated, on %dW / off %dW => %dW"), median_uint16(load_on, CALIBRATE_MEASURE), median_uint16(load_off, CALIBRATE_MEASURE), config.loadPower_W);
    putEvent(event);

    memset(load_on, 0, sizeof(load_on));
    memset(load_off, 0, sizeof(load_off));
    cnt = CALIBRATE_LOOP_CNT;

    systemState.switchEnabled = false;
    currentState = stateForMode(config.mode); // done, back to normal operation
  }
  else
  {
    bool on = (--cnt & CALIBRATE_ONOFF_TOGGLE) == 0;
    if ((cnt & CALIBRATE_MEASURE) == 0) // wait with measure after toggle
    {
      if (on)
      {
        load_on[cnt & (CALIBRATE_MEASURE - 1)] = systemState.cons_W;
      }
      else
      {
        load_off[cnt & (CALIBRATE_MEASURE - 1)] = systemState.cons_W;
      }
    }
    systemState.switchEnabled = on;
  }
}

// dispatch table indexed by SwitchStateId ordinal
static const SwitchStateHandler stateHandlers[STATE_COUNT] = {
    handleCalibrate, // [STATE_CALIBRATE]
    handleOn,        // [STATE_ON]
    handleOff,       // [STATE_OFF]
    handleAuto,      // [STATE_AUTO]
};

uint16_t updateSystemCount = 0; // initially do update

bool isUpdateSystemData()
{
  return updateSystemCount == 0;
}

bool updateSystemCounter()
{
  bool isZero = updateSystemCount-- == 0;
  if (isZero)
  {
    updateSystemCount = 4 * 60 * SYSTEM_UPDATE_INTERVAL_MS / 1000; // every 4 hours
  }
  return isZero;
}

static SystemStatus updateSystemStatus()
{
  if (!ensureConnected())
    return SystemStatus::Error_Network;
  if (!updateSystemData())
    return SystemStatus::Error_Battery;
  if (!updateBoilerData())
    return SystemStatus::Error_Boiler;
  return SystemStatus::Ok;
}

// main loop
void loop()
{
  if (doUpdateFlag)
  {
    feedWatchdog(PHASE_CYCLE);

    if (updateSystemCounter() && ensureConnected())
    {
      configureSystemTime();
    }

    SystemStatus status = updateSystemStatus();

    updateSolarForecast();

    stateHandlers[currentState](status);

    updateSwitch(systemState.switchEnabled);

    doUpdateFlag = false;
    feedWatchdog(PHASE_SERVER); // the cycle is done, only server.handleClient() runs from here

    DEBUGF("ESP Heap %uk CPU: %uMhz valid: %d\n", ESP.getFreeHeap() >> 10, ESP.getCpuFreqMHz(), status);
  }
  server.handleClient();
}

void buildInLED(bool onOff)
{
#ifdef ESP32
  digitalWrite(LED_BUILTIN, onOff ? HIGH : LOW);
#else
  digitalWrite(LED_BUILTIN, onOff ? LOW : HIGH);
#endif
}

void statusLED(int status)
{
  int d = 1000 - (100 * (status % 10));
  for (int i = 0; i < status; i++)
  {
    buildInLED(true);
    delay(d);
    buildInLED(false);
    delay(d);
  }
}

static bool ensureConnected()
{
  wl_status_t status = WiFi.status();
  if (status != WL_CONNECTED)
  {
    DEBUG("Connecting");
    for (int retry = 1; retry <= WIFI_RECONNECT_RETRIES; retry++)
    {
      feedWatchdog(PHASE_WIFI);
      statusLED(0);
      DEBUG(".");
      delay(WIFI_RECONNECT_DELAY_MS);

      status = WiFi.status();
      if (status == WL_CONNECTED)
      {
        DEBUGF("Connected. IP address: %s status: %d\n", WiFi.localIP().toString().c_str(), status);
        break;
      }
      else
      {
        DEBUGF("Wifi not connected, status: %d\n", status);
        if (status == WL_IDLE_STATUS)
        {
          WiFi.disconnect();
          status = WiFi.begin();
        }
      }
    }
    if (status != WL_CONNECTED)
    {
      putEvent(String(F("restart: wifi not connected, status ")) + status);
      restart();
    }
  }
  return status == WL_CONNECTED;
}

bool fetchBatteryApi(String uri, JsonDocument &json, const JsonField *expectedFields, uint8_t expectedFieldCount)
{
  return fetchBatteryApi(uri, json, expectedFields, expectedFieldCount, NULL);
}

bool fetchBatteryApi(String uri, JsonDocument &json, const JsonField *expectedFields, uint8_t expectedFieldCount, JsonDocument *filter)
{

  bool r = false;

  RestClient restClient;

  if (strlen(config.sonnenHostname) && strlen(config.sonnenApiToken))
  {
    char url[128];
    snprintf_P(url, sizeof(url), PSTR("http://%.31s/%s/%s"), config.sonnenHostname, SONNEN_API_URI, uri.c_str());
    feedWatchdog(PHASE_BATTERY);
    r = restClient.get(String(url), json, filter, expectedFields, expectedFieldCount, "auth-token", config.sonnenApiToken);
    if (!r)
    {
      DEBUGF("ERROR: fetchBatteryApi(%s)\n", uri.c_str());
      putBatteryError(restClient.lastError());
    }
  }
  else
  {
    putBatteryError(F("Sonnen Battery Hostname/Token not properly configured!"));
  }
  return r;
}

static bool updateSystemData()
{

  static uint8_t errorLoopBackoff = 1;

  JsonDocument json;

  if (systemState.skipUpdateCountSysten > 0)
  {
    systemState.skipUpdateCountSysten--;
    return false;
  }

  bool ok = true;

  if (systemState.inv_max_w == -1)
  {
    if ((ok &= fetchBatteryApi(SONNEN_API_CONFIGURATIONS, json, SONNEN_FIELDS_CONFIGURATIONS, JSON_FIELD_COUNT(SONNEN_FIELDS_CONFIGURATIONS))))
    {
      systemState.inv_max_w = json[FPSTR(KEY_SN_INVERTER_MAX_POWER_W)].as<int>();
      systemState.cap_bat_new_Wh = json[FPSTR(KEY_SN_MODULE_CAPACITY)].as<int>() * json[FPSTR(KEY_SN_BATTERY_MODULES)].as<int>() * 90 / 100;
      DEBUGF("IC_InverterMaxPower_w %d, max battery capacity %d\n", systemState.inv_max_w, systemState.cap_bat_new_Wh);
    }
  }
  if (systemState.cap_bat_max_Wh == 0 || isUpdateSystemData())
  {
    if (ok && (ok &= fetchBatteryApi(SONNEN_API_BATTERY, json, SONNEN_FIELDS_BATTERY, JSON_FIELD_COUNT(SONNEN_FIELDS_BATTERY))))
    {
      systemState.cap_bat_max_Wh = json[FPSTR(KEY_SN_FULL_CHARGE_CAPACITY_WH)].as<uint16_t>();
      systemState.bat_cycles = json[FPSTR(KEY_SN_CYCLE_COUNT)].as<uint16_t>();
      systemState.cap_bat_soh = systemState.cap_bat_new_Wh == 0 ? 0 : systemState.cap_bat_max_Wh * 100 / systemState.cap_bat_new_Wh;
      DEBUGF("FullChargeCapacity %d, cycles: %d, capacity: %2d%%\n", systemState.cap_bat_max_Wh, systemState.bat_cycles, systemState.cap_bat_soh);
    }
  }
  JsonDocument filter;
  filter[FPSTR(KEY_SN_UTC_OFFSET)] = true;
  filter[FPSTR(KEY_SN_IC_STATUS)][FPSTR(KEY_SN_SETPOINT_PRIORITY)][FPSTR(KEY_SN_FULL_CHARGE_REQUEST)] = true;
  filter[FPSTR(KEY_SN_IC_STATUS)][FPSTR(KEY_SN_NEXT_FULL_CHARGE_START)] = true;
  filter[FPSTR(KEY_SN_IC_STATUS)][FPSTR(KEY_SN_SECONDS_SINCE_FULL_CHARGE)] = true;
  if (ok && (ok &= fetchBatteryApi(SONNEN_API_LATEST_DATA, json, SONNEN_FIELDS_LATEST_DATA, JSON_FIELD_COUNT(SONNEN_FIELDS_LATEST_DATA), &filter)))
  {
    systemState.utc_offset = json[FPSTR(KEY_SN_UTC_OFFSET)].as<int16_t>() * 3600;
    systemState.fullChargeRequest = json[FPSTR(KEY_SN_IC_STATUS)][FPSTR(KEY_SN_SETPOINT_PRIORITY)][FPSTR(KEY_SN_FULL_CHARGE_REQUEST)].as<bool>();
    systemState.fullChargeRequestIn =
        json[FPSTR(KEY_SN_IC_STATUS)][FPSTR(KEY_SN_NEXT_FULL_CHARGE_START)].as<uint32_t>() -
        json[FPSTR(KEY_SN_IC_STATUS)][FPSTR(KEY_SN_SECONDS_SINCE_FULL_CHARGE)].as<uint32_t>();

    DEBUGF("UTC offset %d, discharge not allowed: %d %u\n", systemState.utc_offset, systemState.fullChargeRequest, systemState.fullChargeRequestIn);
  }
  if (ok && (ok &= fetchBatteryApi(SONNEN_API_STATUS, json, SONNEN_FIELDS_STATUS, JSON_FIELD_COUNT(SONNEN_FIELDS_STATUS))))
  {
    systemState.usoc = json[FPSTR(KEY_SN_USOC)].as<uint8_t>();
    systemState.cap_bat_Wh = systemState.cap_bat_max_Wh * systemState.usoc / 100;
    systemState.gridFeedIn_W = json[FPSTR(KEY_SN_GRID_FEED_IN_W)].as<int>();
    systemState.prod_W = json[FPSTR(KEY_SN_PRODUCTION_W)].as<uint16_t>();
    systemState.cons_W = json[FPSTR(KEY_SN_CONSUMPTION_W)].as<uint16_t>();
    systemState.pac_total_W = json[FPSTR(KEY_SN_PAC_TOTAL_W)].as<int16_t>();
    systemState.charge = json[FPSTR(KEY_SN_BATTERY_CHARGING)].as<short>() - json[FPSTR(KEY_SN_BATTERY_DISCHARGING)].as<short>();

    struct tm time;
    strptime(json[FPSTR(KEY_SN_TIMESTAMP)].as<const char *>(), "%Y-%m-%d %H:%M:%S", &time);

    systemState.ts = mktime(&time) - systemState.utc_offset; // to UTC
    if (systemState.start_ts == 0)
    {
      systemState.start_ts = systemState.ts;
    }

    int16_t prev_stat_key = systemState.stat_hour_key;
    updateSystemState(&config, &systemState);
    if (systemState.stat_hour_key != prev_stat_key && prev_stat_key != -1)
    {
      saveConfig();
    }
  }

  if (ok && !(ok &= (config.loadPower_W > 0)))
  {
    // TODO wrong error category
    putBatteryError("Load not properly configured! Must be > 0!");
  }

  if (ok)
  {
    clearBatteryError();
    errorLoopBackoff = 1; // reset backoff
  }
  else
  {
    systemState.skipUpdateCountSysten = errorLoopBackoff; // error loop back off
    if (errorLoopBackoff != (1 << 7))
    {
      errorLoopBackoff <<= 1;
    }
  }

  return ok;
}

static void updateSwitch(bool switchEnabled)
{
  digitalWrite(PIN_SSR, switchEnabled ? HIGH : LOW);
  buildInLED(switchEnabled);
}

static uint8_t logSegment = 0; // active segment 0..LOG_SEGMENTS - 1
static uint32_t logSize = 0;   // payload of the active segment, tracked in ram

static String logSegmentPath(uint8_t segment)
{
  char path[24];
  snprintf_P(path, sizeof(path), PSTR(LOGFILE_PATTERN), segment);
  return String(path);
}

// remembers the active segment across restarts, size is the payload as of the last save
static bool saveEventLogIndex()
{
  File f = LittleFS.open(LOGFILE_INDEX, "w");
  if (!f)
  {
    DEBUGF("Could not open log index %s for writing\n", LOGFILE_INDEX);
    return false;
  }

  JsonDocument json;
  json[F("current")] = logSegment;
  json[F("size")] = logSize;
  serializeJson(json, f);
  f.close();
  return true;
}

// restores the active segment and closes an entry that a power loss cut in half
static void loadEventLogIndex()
{
  File index = LittleFS.open(LOGFILE_INDEX, "r");
  if (index)
  {
    JsonDocument json;
    if (deserializeJson(json, index) == DeserializationError::Ok)
    {
      logSegment = json[F("current")].as<uint8_t>() % LOG_SEGMENTS;
    }
    index.close();
  }

  String path = logSegmentPath(logSegment);
  bool unterminated = false;

  if (LittleFS.exists(path)) // missing before the very first entry is written
  {
    File segment = LittleFS.open(path, "r");
    logSize = segment.size();
    if (logSize > 0)
    {
      segment.seek(logSize - 1);
      unterminated = segment.read() != '\n';
    }
    segment.close();
  }

  if (unterminated) // terminate the torn entry, it is dropped later because it does not parse
  {
    File f = LittleFS.open(path, "a");
    if (f)
    {
      f.write('\n');
      f.close();
      logSize++;
    }
  }
  DEBUGF("event log segment %u, %u bytes\n", logSegment, logSize);
}

// starts the next segment, emptying it keeps "payload == file size" true for every segment
static void rotateEventLog()
{
  logSegment = (logSegment + 1) % LOG_SEGMENTS;
  logSize = 0;

  File f = LittleFS.open(logSegmentPath(logSegment), "w"); // drops the previous generation
  if (f)
  {
    f.close();
  }
  saveEventLogIndex();
}

// one json line per entry, an entry is never split across two segments
static void appendEventLog(const logEntry &log)
{
  JsonDocument json;
  json[F("ts")] = log.ts;
  json[F("msg")] = log.msg;
  size_t len = measureJson(json) + 1; // plus the record separator

  if (logSize + len > LOG_SEGMENT_MAX_SIZE)
  {
    rotateEventLog();
  }

  File f = LittleFS.open(logSegmentPath(logSegment), "a");
  if (!f)
  {
    DEBUGF("Could not open log segment %u for writing\n", logSegment);
    return;
  }
  serializeJson(json, f);
  f.write('\n');
  f.close();
  logSize += len;
}

// collects the youngest entries of one segment, newest first
static void addEventLogSegment(JsonArray &array, uint8_t segment)
{
  File f = LittleFS.open(logSegmentPath(segment), "r");
  if (!f)
  {
    return;
  }

  uint32_t offsets[LOG_VIEW_ENTRIES];
  uint16_t count = 0;

  if (f.size() > LOG_VIEW_TAIL_SIZE)
  {
    f.seek(f.size() - LOG_VIEW_TAIL_SIZE);
    f.readStringUntil('\n'); // the jump lands inside an entry, drop its remainder
  }
  while (f.available())
  {
    offsets[count++ % LOG_VIEW_ENTRIES] = f.position();
    f.readStringUntil('\n');
  }

  uint16_t entries = MIN(count, (uint16_t)LOG_VIEW_ENTRIES);
  for (uint16_t i = 1; i <= entries && array.size() < LOG_VIEW_ENTRIES; i++)
  {
    f.seek(offsets[(count - i) % LOG_VIEW_ENTRIES]);

    JsonDocument entry;
    if (deserializeJson(entry, f.readStringUntil('\n')) != DeserializationError::Ok)
    {
      continue; // torn or corrupted entry
    }
    JsonObject e = array.add<JsonObject>();
    e[F("ts")] = entry[F("ts")].as<uint32_t>();
    e[F("msg")] = entry[F("msg")].as<String>(); // as String, so the text is copied
  }
  f.close();
}

// hands the youngest entries to the ui, walking the segment ring backwards
static void addEventLog(JsonArray &array)
{
  uint8_t segment = logSegment;
  for (uint8_t i = 0; i < LOG_SEGMENTS && array.size() < LOG_VIEW_ENTRIES; i++)
  {
    if (!LittleFS.exists(logSegmentPath(segment)))
    {
      break; // the ring has not wrapped around yet, there is no older history
    }
    addEventLogSegment(array, segment);
    segment = (segment + LOG_SEGMENTS - 1) % LOG_SEGMENTS;
  }
}

static bool loadConfig()
{
  if (!LittleFS.exists(CONFIGFILE))
  {
    DEBUGLN("Config file not found");

    return false;
  }

  File f = LittleFS.open(CONFIGFILE, "r");
  if (!f)
  {
    DEBUGF("Could not open config file %s\n", CONFIGFILE);

    return false;
  }

  JsonDocument json;
  DeserializationError error = deserializeJson(json, f);
  f.close();

  if (error)
  {
    return false;
  }

  DEBUGLN("Config loaded:");
  serializeJsonPretty(json, Serial);

  jsonToConfig(json);

  return true;
}

static bool saveConfig(bool updateVersion)
{
  File f = LittleFS.open(CONFIGFILE, "w");
  if (!f)
  {
    DEBUGF("Could not open config file %s for writing\n", CONFIGFILE);
    return false;
  }

  if (updateVersion)
    config.version++; // update version

  JsonDocument json;
  configToJson(json, false);
  DEBUGLN("saveConfig() => ");
  serializeJsonPretty(json, Serial);
  serializeJson(json, f);
  f.close();
  saveConfigFile = false;
  return true;
}

static bool saveConfig()
{
  return saveConfig(true);
}
