mlauke/smartswitch/smartswitch.espxx/include/SmartSwitch.h

// MIT License
//
// Copyright (c) 2024 Marko Lauke
//
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
#ifndef SMARTSWITCH_H
#define SMARTSWITCH_H

#include <stdint.h>

#ifdef ESP32
#define PIN_LPB_TX GPIO_NUM_17
#define PIN_LPB_RX GPIO_NUM_16
#define PIN_SSR GPIO_NUM_23

#elif ESP8266
#define LED_BUILTIN 2
#define PIN_LPB_TX 5 // GPIO5 (D1)
#define PIN_LPB_RX 4 // GPIO4 (D2)
#define PIN_SSR 13   // GPIO13 (D7)
#endif

#define HOSTNAME "smartswitch"
#define RELEASE_TAG "-"
#define CONFIGFILE "/config.json"

#define SERIAL_BAUDRATE 115200
#define WEBSERVER_PORT 80

#define NTP_SERVER_PRIMARY "pool.ntp.org"
#define NTP_SERVER_SECONDARY "time.nist.gov"
#define NTP_SYNC_TIMEOUT_MS 5000
#define NTP_SYNC_POLL_MS 250
#define NTP_SYNC_EPOCH 1700000000 // Nov 2023 - anything below means the clock is unset

#define LPB_BAUDRATE 4800
#define LPB_ADDR_SELF 2
#define LPB_ADDR_DEST 0
#define LPB_RETRIES 5

#define WIFI_RECONNECT_RETRIES 8
#define WIFI_RECONNECT_DELAY_MS 500

// the watchdog is fed between the blocking calls (feedWatchdog() in main.ino), so it only has to
// cover the longest single phase: one rest request, or the boiler transfer which runs as one block.
// derived from REQUEST_TIMEOUT (RestClient.h) and the LPB timings (LPB.h), so the watchdog follows
// automatically when one of those timeouts is changed
#define LPB_UPDATE_TIMEOUT_MS (LPB_QUERIES_PER_UPDATE * QUERY_RETRIES * (LPB_BUS_FREE_TIMEOUT_MS + LPB_REPLY_TIMEOUT_MS))
#define SYSTEM_UPDATE_TIMEOUT_MS MAX(REQUEST_TIMEOUT, LPB_UPDATE_TIMEOUT_MS)

#define WDT_RESERVE_MS 10000 // headroom for everything that is not a remote call
#define WDT_TIMEOUT_S ((SYSTEM_UPDATE_TIMEOUT_MS + WDT_RESERVE_MS) / 1000)

#define SYSTEM_UPDATE_INTERVAL_MS 2000 // update intervall millis
#define SYSTEM_ON_COUNT MAX(1, (10000 + (SYSTEM_UPDATE_INTERVAL_MS >> 1)) / SYSTEM_UPDATE_INTERVAL_MS)

#define SONNEN_API_URI "api/v2"
#define SONNEN_API_CONFIGURATIONS "configurations"
#define SONNEN_API_LATEST_DATA "latestdata"
#define SONNEN_API_BATTERY "battery"
#define SONNEN_API_STATUS "status"
#define SONNEN_INVERTER_LATENCY_MS 5000 // battery inverter latency until load is compensated - sonnen battery 10 specific
#define SONNEN_INVERTER_LATENCY_COUNT (1 + (SONNEN_INVERTER_LATENCY_MS + (SYSTEM_UPDATE_INTERVAL_MS >> 1)) / SYSTEM_UPDATE_INTERVAL_MS)

#define URL_LOCATION "http://ip-api.com/json/"

#define SOLAR_FORECAST_INTERVAL_MS (12 * 60 * 1000) // update intervall every 12min
#define SOLAR_FORECAST_HOURS 49                     // 49h
#define SOLAR_FORECAST_SAFETY_FACTOR 0.95f
#define URL_SOLAR_FORECAST "http://api.forecast.solar/estimate/watthours/period/%.4f/%.4f/%d/%d/%.2f?time=seconds&no_sun=0&full=1"
#define URL_SOLAR_FORECAST_DEV "http://192.168.188.20:8080/estimate/watthours/period/%.4f/%.4f/%d/%d/%.2f?time=seconds&no_sun=0&full=1"

#define GRID_PURCHASE_THRESHOLD_W 100
#define BATTERY_USOC_OFF 3
#define BATTERY_USOC_ON 10

#define BOILER_TEMPERATURE_HYSTERESIS 2
#define BOILER_AFTERGLOW_K_PER_KW 0.5f // heater afterglow rises with load power: 1 kW -> 0.5 °C
#define BOILER_BOOST_REMAINING_PCT 65  // below this share of today's yield the pv day is running out
#define BOILER_UPDATE_INTERVAL_SECONDS 15

#define CFG_SZ_HOSTNAME 32
#define CFG_SZ_REL_TAG 5
#define CFG_SZ_SONNENHOST 32
#define CFG_SZ_SONNENTOKEN 37
#define CFG_SZ_LOCATION 64
#define CFG_SZ_TZ 32
#define SZ_LOG_ENTRY 256

#define CALIBRATE_LOOP_CNT (1 << 5)
#define CALIBRATE_ONOFF_TOGGLE (CALIBRATE_LOOP_CNT >> 1)
#define CALIBRATE_MEASURE (CALIBRATE_ONOFF_TOGGLE >> 1)
#define CALIBRATE_AVG_DIV (CALIBRATE_LOOP_CNT / CALIBRATE_ONOFF_TOGGLE / 2 * CALIBRATE_MEASURE)

#define LOGFILE_INDEX "/eventlog.json"
#define LOGFILE_PATTERN "/eventlog-%02u.log"
#define LOG_SEGMENTS 4
#define LOG_SEGMENT_MAX_SIZE (16 * 1024)
#define LOG_VIEW_ENTRIES 16     // entries handed to the ui
#define LOG_VIEW_TAIL_SIZE 4096 // bytes scanned back from a segment's end to find them

#define MIN(a, b) ((a) < (b) ? (a) : (b))
#define MAX(a, b) ((a) > (b) ? (a) : (b))

#define _cs(a) sizeof(((SystemConfig *)0)->a)
#define setConfigStr(cfg, property, str)                          \
  {                                                               \
    const char *tmp = str;                                        \
    if (tmp && *tmp)                                              \
    {                                                             \
      snprintf_P((cfg).property, _cs(property), PSTR("%s"), tmp); \
    }                                                             \
  }

enum SystemStatus
{
  Ok,
  Error_Network,
  Error_Battery,
  Error_Boiler
};

static const char *SystemStatusLabel[4]{
    "Ok",
    "Network",
    "Battery",
    "Boiler"};

enum SwitchMode
{
  SMODE_OFF,
  SMODE_ON,
  SMODE_AUTO
};

// runtime states of the load switch state machine, dispatched by ordinal
enum SwitchStateId
{
  STATE_CALIBRATE,
  STATE_ON,
  STATE_OFF,
  STATE_AUTO,
  STATE_COUNT // sentinel: number of states / handler table size
};

// phase of the update cycle, kept across a reset so a watchdog reboot can name what was blocking
enum WatchdogPhase
{
  PHASE_IDLE, // nothing to report, set on an intentional restart
  PHASE_SERVER,
  PHASE_CYCLE,
  PHASE_WIFI,
  PHASE_BATTERY,
  PHASE_FORECAST,
  PHASE_BOILER,
  PHASE_UPDATE,
  PHASE_COUNT // sentinel: number of phases / label table size
};

#define WATCHDOG_PHASE_MAGIC 0x5750484Aul // marks the phase as written by this firmware

#ifdef ESP32
#define RESET_PERSIST_ATTR RTC_NOINIT_ATTR // dram can be clobbered by the bootloader, rtc memory cannot
#elif ESP8266
#define RESET_PERSIST_ATTR __attribute__((section(".noinit")))
#else
#define RESET_PERSIST_ATTR
#endif

typedef void (*SwitchStateHandler)(SystemStatus status);
typedef struct
{

  char hostname[CFG_SZ_HOSTNAME];
  char release_tag[CFG_SZ_REL_TAG];
  char sonnenHostname[CFG_SZ_SONNENHOST];
  char sonnenApiToken[CFG_SZ_SONNENTOKEN];

  uint16_t loadPower_W;
  uint8_t bat_soc_min; // battery min capacity as SoC (0..100%) - custom min capacity
  uint16_t gridMin_W;
  float lat;
  float lon;
  float kWp;   // installed PV power
  uint8_t dec; // PV panel declination (0..90°)
  uint16_t az; // PV panel Azimuth 0..360°
  char location[CFG_SZ_LOCATION];
  char tz[CFG_SZ_TZ + 1];
  enum SwitchMode mode;          // 0 - off, 1 - on, 2 - automatic
  bool update_startup;           // release update check on startup
  uint16_t cons_stats_Wh[7][24]; // avg consumption per weekday (0=Sun) x hour (Watt), true hourly mean blended via cross-week EMA α=0.1
  uint16_t version;              //
} SystemConfig;

typedef struct
{
  uint32_t ts;
  char msg[SZ_LOG_ENTRY];
} logEntry;

typedef struct
{
  uint32_t start_ts;  // system start timestamp
  uint32_t ts;        // current system timestamp in seconds (UTC) - taken from battery status
  int16_t utc_offset; // UTC to local time offset in seconds
  bool switchEnabled; // state of the load switch

  float boiler_T_cur;
  float boiler_T_nom;
  float boiler_T_min;
  float boiler_T_max;

  int16_t inv_max_w;            // inverter power max - max charge/discharge power
  uint8_t usoc;                 // 0..100 user state of charge - battery capacity in %
  uint16_t system_Power_W;      // production + battery inverter max power (Watt) if battery usoc is >0
  uint16_t prod_W;              // current PV production (Watt)
  uint16_t cons_W;              // current consumption (Watt)
  uint16_t cons_W_nom;          // consumption rounded as multiple of 10 (Watt)
  uint16_t cons_W_norm;         // normalized consumption without load (Watt)
  uint16_t cons_avg_W;          // consumption average (W) - long term mean over hours, used to build statistics
  uint16_t bat_cycles;          // Number of charge/discharge cycles
  uint16_t cap_bat_new_Wh;      // max usable battery capacity for new battery
  uint8_t cap_bat_soh;          // percentage of usable battery capacity (SoH)
  uint16_t cap_bat_Wh;          // current capacity
  uint16_t cap_bat_max_Wh;      // max battery capacity (system)
  int16_t pac_total_W;          // inverter ac power -   AC Power greater than ZERO is discharging Inverter AC Power less than ZERO is charging
  int16_t gridFeedIn_W;         // current grid feed in - negative is consumption, positive is feed in
  bool fullChargeRequest;       // e.g. true during battery maintenance
  uint32_t fullChargeRequestIn; // next full charge request starts in given seconds
  int8_t charge;                // battery charge state 0 - none, 1 - charge, -1 - discharge

  long pv_forecast_ts;                                 // last update timestamp in ms since mcu start
  uint32_t pv_forecast_ts_wh[SOLAR_FORECAST_HOURS][2]; // pair of timestamp and pv production (Wh/h) for 48h (today and tomorrow)

  uint8_t skipUpdateCountSysten; // skip update on error count

  logEntry error_bs; // last boiler system error
  logEntry error_bt; // last battery error
  logEntry error_lc; // last solar forecast or location error
  uint8_t errorIx = 0;

  int16_t stat_hour_key = -1; // weekday*24+hour key of last stats update, -1 = uninitialized

  uint32_t cons_sum_W = 0; // running sum of cons_W_norm within current hour
  uint16_t cons_count = 0; // number of samples accumulated in current hour

} SystemState;

#endif
