mlauke/smartswitch/smartswitch.espxx/include/app_css.h

const char app_css[] PROGMEM = { 0x1F, 0x8B, 0x08, 0x08, 0x8F, 0x14, 0x8B, 0x6A, 0x02, 0x03, 0x61, 0x70, 0x70, 0x2E, 0x63, 0x73, 0x73, 0x00, 0xAD, 0x59, 0xDB, 0x6E, 0xE3, 0x36, 0x10, 0x7D, 0xDF, 0xAF, 0x10, 0x12, 0x04, 0x88, 0x01, 0xD3, 0x90, 0x65, 0xCB, 0x71, 0x1C, 0x6C, 0xB1, 0xBD, 0x60, 0xD1, 0x87, 0x02, 0x7D, 0x6D, 0xB1, 0xE8, 0x03, 0x2D, 0x51, 0x36, 0x1B, 0x4A, 0x14, 0x48, 0x3A, 0x4E, 0xB6, 0xD8, 0x7F, 0xEF, 0xF0, 0x26, 0x51, 0xB4, 0x94, 0x4D, 0x8A, 0xC6, 0x0B, 0x47, 0xA1, 0xC8, 0xE1, 0xCC, 0x99, 0x99, 0x33, 0x43, 0xEE, 0x82, 0x3F, 0x11, 0xC1, 0xF0, 0x4B, 0xF2, 0xCF, 0x87, 0x24, 0x69, 0xB9, 0xA4, 0x8A, 0xF2, 0x66, 0x97, 0x54, 0xF4, 0x99, 0x94, 0x0F, 0x30, 0xA4, 0x78, 0xBB, 0x4B, 0x52, 0xFD, 0xC4, 0x48, 0xA5, 0xDC, 0xE3, 0x9E, 0x3F, 0x23, 0x49, 0xBF, 0xD2, 0xE6, 0xB0, 0x83, 0x67, 0x51, 0x12, 0x81, 0x60, 0x48, 0xBF, 0xA9, 0x69, 0x83, 0xCE, 0xB4, 0x54, 0xC7, 0x5D, 0xB2, 0x4C, 0xD3, 0x1B, 0x3D, 0x54, 0x52, 0xD9, 0xC2, 0x06, 0x20, 0x93, 0x11, 0x33, 0x47, 0xFF, 0x46, 0x25, 0x15, 0xA4, 0xB0, 0x7B, 0x15, 0x9C, 0x9D, 0xEA, 0x46, 0xBF, 0xC1, 0x8C, 0x1E, 0x1A, 0x44, 0x15, 0xA9, 0xE5, 0x2E, 0x91, 0x0A, 0x0B, 0x65, 0x76, 0xC3, 0xC5, 0xE3, 0x41, 0xF0, 0x53, 0x53, 0xEE, 0x12, 0x71, 0xD8, 0xE3, 0xDB, 0x74, 0x9E, 0xB8, 0x7F, 0x8B, 0xBB, 0x99, 0x9E, 0xF1, 0x44, 0x25, 0xDD, 0x53, 0x46, 0x15, 0xEC, 0x72, 0xA4, 0x65, 0x49, 0x8C, 0x34, 0x25, 0x70, 0xE3, 0xED, 0xE1, 0x2D, 0x2E, 0xE0, 0x35, 0xAC, 0x58, 0xC9, 0x84, 0x60, 0x49, 0xE6, 0xC1, 0xA2, 0x7E, 0xD4, 0x1A, 0xA7, 0x0D, 0x02, 0xFD, 0xDB, 0xE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
9, 0x96, 0x02, 0x5E, 0xB9, 0xC1, 0x6C, 0xDD, 0x17, 0xB3, 0x80, 0x7F, 0xE7, 0x5E, 0x9C, 0x47, 0x28, 0xE8, 0x18, 0x31, 0x1E, 0xAE, 0x88, 0x8A, 0xC5, 0x77, 0x6C, 0xB9, 0xA0, 0xA2, 0x0B, 0xC9, 0xC3, 0x5C, 0x47, 0x03, 0x1E, 0x37, 0x85, 0xF3, 0x5F, 0xDE, 0x82, 0x95, 0xA9, 0xA7, 0x1A, 0x00, 0x00,  };
