mlauke/smartswitch/smartswitch.espxx/include/index_html.h

const char index_html[] PROGMEM = { 0x1F, 0x8B, 0x08, 0x08, 0x4C, 0x15, 0x8B, 0x6A, 0x02, 0x03, 0x69, 0x6E, 0x64, 0x65, 0x78, 0x2E, 0x68, 0x74, 0x6D, 0x6C, 0x00, 0xC5, 0x5A, 0xDB, 0x72, 0xE3, 0x36, 0x12, 0x7D, 0xF7, 0x57, 0x20, 0xDC, 0x9A, 0x1A, 0xB9, 0x2A, 0xB2, 0x64, 0x4F, 0x32, 0x49, 0xA6, 0x24, 0x4E, 0xD9, 0x1A, 0xCF, 0xA5, 0x6A, 0x2E, 0x2E, 0xCB, 0x59, 0x27, 0x4F, 0x2A, 0x88, 0x84, 0x44, 0x44, 0x10, 0xC0, 0x02, 0x40, 0xC9, 0x9A, 0x0F, 0xD9, 0xEF, 0x48, 0xED, 0x73, 0x9E, 0xF2, 0x29, 0xFB, 0x25, 0xDB, 0x00, 0xC1, 0x9B, 0x44, 0x5D, 0x2C, 0xC9, 0x19, 0x3F, 0x98, 0x02, 0xD8, 0x97, 0x83, 0x46, 0xA3, 0xBB, 0x01, 0xB0, 0xF3, 0xDD, 0x9B, 0x2F, 0xBD, 0xBB, 0xDF, 0x6F, 0xAE, 0x51, 0xA4, 0xA7, 0xCC, 0x3F, 0xE9, 0xA4, 0x0F, 0x78, 0x12, 0x1C, 0xFA, 0x27, 0x08, 0x75, 0x34, 0xD5, 0x8C, 0xF8, 0x7D, 0xC1, 0x39, 0xE1, 0xA8, 0x3F, 0xC5, 0x52, 0xF7, 0xE7, 0x54, 0x07, 0x51, 0xA7, 0x95, 0xBE, 0x31, 0x34, 0x53, 0xA2, 0x31, 0xE2, 0x78, 0x4A, 0xBA, 0xDE, 0x8C, 0x92, 0x79, 0x2C, 0xA4, 0xF6, 0x50, 0x20, 0xB8, 0x26, 0x5C, 0x77, 0xBD, 0x39, 0x0D, 0x75, 0xD4, 0x0D, 0xC9, 0x8C, 0x06, 0xA4, 0x69, 0x1B, 0xDF, 0x23, 0xCA, 0xA9, 0xA6, 0x98, 0x35, 0x55, 0x80, 0x19, 0xE9, 0x9E, 0x7B, 0x56, 0x0C, 0xA3, 0x7C, 0x82, 0x24, 0x61, 0x5D, 0x4F, 0xE9, 0x05, 0x23, 0x2A, 0x22, 0x04, 0xE4, 0x44, 0x92, 0x8C, 0xBA, 0x5E, 0x0B, 0xC7, 0xF1, 0x59, 0xA0, 0x14, 0x50, 0x76, 0x5A, 0x29, 0xB8, 0x93, 0xCE, 0x50, 0x84, 0x0B, 0xCB, 0x19, 0x9D, 0xD7, 0x20, 0x44, 0x1D, 0x15, 0x63, 0x8E, 0x02, 0x86, 0x95, 0xEA, 0x7A, 0x20, 0x97, 0x60, 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
