mlauke/smartswitch/smartswitch.espxx/include/app_js.h

const char app_js[] PROGMEM = { 0x1F, 0x8B, 0x08, 0x08, 0x42, 0x52, 0xD7, 0x69, 0x02, 0x03, 0x61, 0x70, 0x70, 0x2E, 0x6A, 0x73, 0x00, 0xBD, 0x19, 0x6D, 0x6F, 0xDB, 0xB8, 0xF9, 0x7B, 0x7E, 0x05, 0xAB, 0xED, 0xCE, 0xD2, 0xE2, 0x28, 0x4E, 0x37, 0xDC, 0x87, 0x64, 0xE9, 0x21, 0x6D, 0x53, 0x34, 0x40, 0xBA, 0x04, 0x6B, 0xAE, 0xDD, 0x60, 0x04, 0x3D, 0x5A, 0xA2, 0x2D, 0xB5, 0xB4, 0xE8, 0x13, 0x29, 0x39, 0x46, 0xCE, 0xC0, 0x7E, 0xC4, 0x7E, 0xE1, 0x7E, 0xC9, 0x9E, 0x87, 0xA4, 0x28, 0x4A, 0x96, 0xD3, 0xEC, 0xCB, 0x02, 0xC4, 0x96, 0xC8, 0xE7, 0xFD, 0x9D, 0xF4, 0x41, 0x4D, 0x4B, 0x22, 0x37, 0x52, 0xB1, 0xE5, 0x5B, 0xAA, 0xE8, 0x27, 0x56, 0xCA, 0x5C, 0x14, 0xE4, 0x9C, 0x1C, 0x9D, 0x9C, 0x1D, 0xE0, 0x5E, 0x22, 0x0A, 0xF9, 0x51, 0x51, 0x25, 0x61, 0xAD, 0xA8, 0x38, 0x37, 0xAB, 0xAB, 0xFA, 0x9D, 0x28, 0x59, 0x42, 0xA5, 0x7A, 0xBD, 0x79, 0x4B, 0x37, 0xEF, 0x45, 0x55, 0x36, 0xFB, 0xE4, 0xF8, 0x98, 0x3C, 0xA6, 0x74, 0x73, 0x33, 0xFF, 0xCC, 0xD8, 0xB7, 0x53, 0xF2, 0x98, 0xC1, 0xE6, 0x29, 0x59, 0x67, 0xDB, 0xED, 0xC1, 0x01, 0x95, 0x9B, 0x22, 0x21, 0xF3, 0xAA, 0x48, 0x14, 0xB2, 0x99, 0x33, 0x95, 0x64, 0x17, 0xB7, 0x57, 0x61, 0x55, 0xE6, 0x63, 0x92, 0xCC, 0x22, 0xF2, 0x78, 0x70, 0x40, 0x08, 0x72, 0x28, 0x99, 0x5C, 0x01, 0x6B, 0x76, 0x66, 0xDF, 0x53, 0x90, 0x0E, 0x9F, 0x55, 0xB9, 0x01, 0x20, 0x02, 0x7F, 0x0D, 0x04, 0x30, 0xA6, 0x6B, 0x9A, 0x2B, 0x43, 0x0D, 0x49, 0x45, 0x67, 0x1A, 0x20, 0x9F, 0x93, 0xF0, 0x45, 0x03, 0x15, 0x8B, 0x6F, 0x91, 0x45, 0x04, 0x22, 0x59, 0x29, 0xD6, 0xA4, 0x60, 0x6B, 0x72, 0x59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
