mlauke/smartswitch/src/smartswitch.espxx/GithubOTA.cpp

#include <Arduino.h>
#include <ArduinoJson.h>
#include <WiFiClientSecure.h>

#ifdef ESP32
#include <Update.h>
#elif defined(ESP8266)
#include <ESP8266HTTPClient.h>
#include <ESP8266httpUpdate.h>
#endif

#include "GithubOTA.h"
#include "WiFiUtil.h"

GithubOTA::GithubOTA(const char* host, const char* url, const char* type, const char* filename) {
  update_host = host;
  update_url = url;
  update_type = type;
  update_filename = filename;
}

bool GithubOTA::checkUpdate(const char* current_release_tag) {

  JsonDocument doc;
  RestClient restClient;

  String url = String(update_host) + update_url;

  if (restClient.fetch(url, doc)) {
    if (!doc["tag_name"].is<const char*>()) {
      Serial.println("no release tag found");
      return false;
    }

    release_tag = String(doc["tag_name"]);

    Serial.printf("Found release %s - Current release %s - Prerelease: %d\n", release_tag.c_str(), current_release_tag, doc["prerelease"].as<bool>());

    if (strncmp(release_tag.c_str(), current_release_tag, strlen(current_release_tag)) == 0 || doc["prerelease"].as<bool>()) {
      return false;
    }

    for (auto asset : doc["assets"].as<JsonArray>()) {
      const char* asset_type = asset["content_type"];
      const char* asset_name = asset["name"];
      const char* asset_url = asset["browser_download_url"];

      Serial.printf("asset found: Name: [%s], Type: [%s], URL: [%s]\n", asset_name, asset_type, asset_url);
      Serial.printf("expected: [%s], Type: [%s]\n", update_filename, update_type);

      if (strcmp(asset_type, update_type) == 0 && strcmp(asset_name, update_filename) == 0) {
        download_url = String(asset_url);

        Serial.println("Update URL: " + download_url);

        return true;
      }
    }
  }
  Serial.println("No update asset found");
  return false;
}

void onOTAProgress(size_t current, size_t final) {
  static long ota_progress_millis = 0;
  // Log every 1 second
  if (millis() - ota_progress_millis > 1000) {
    ota_progress_millis = millis();
    Serial.printf("OTA Progress Current: %u bytes, Final: %u bytes\n", current, final);
  }
}

String GithubOTA::getUpdateError() {
#ifdef ESP32
  return "Update Failed: " + String(Update.errorString());
#elif defined(ESP8266)
  return "Update Failed: " + ESPhttpUpdate.getLastErrorString();
#endif
}

bool GithubOTA::doUpdate(void (*fnOTABegin)(void)) {

  bool success = false;

  if (download_url.length() == 0) {
    Serial.println("No download URL");
    return false;
  }

  WiFiClient* updateClient = newWiFiClient(download_url);

#ifdef ESP32

  HTTPClient http;

  http.begin(*updateClient, download_url);
  int httpCode = http.GET();

  if (httpCode == HTTP_CODE_OK) {
    int contentLength = http.getSize();

    Update.onProgress(onOTAProgress);

    bool canBegin = Update.begin(contentLength);
    if (canBegin) {
      
      fnOTABegin();

      Serial.println("Begin OTA...");
      size_t written = Update.writeStream(http.getStream());

      if (written == contentLength) {
        Serial.println("Written : " + String(written) + " successfully");
      } else {
        Serial.println("Written only : " + String(written) + "/" + String(contentLength) + ". Retry?");
      }
      
      if (Update.end()) {
        Serial.println("OTA done!");
        if (Update.isFinished()) {
          Serial.println("Update successfully completed.");
          success = true;          
        } else {
          Serial.println("Update not finished? Something went wrong!");
        }
      } else {
        Serial.println("Error Occurred. Error #: " + String(Update.getError()));
      }
    } else {
      Serial.println("Not enough space to begin OTA");
    }
  } else {
    Serial.println("Failed to download firmware. HTTP code: " + String(httpCode));
  }
  http.end();

#elif defined(ESP8266)

  ESPhttpUpdate.onStart(fnOTABegin);
  ESPhttpUpdate.onProgress(onOTAProgress);
  ESPhttpUpdate.setLedPin(LED_BUILTIN, HIGH);
  ESPhttpUpdate.setClientTimeout(10000);
  ESPhttpUpdate.rebootOnUpdate(false);  // restart from outside
  ESPhttpUpdate.setFollowRedirects(HTTPC_STRICT_FOLLOW_REDIRECTS);

  success = ESPhttpUpdate.update(*updateClient, download_url) == HTTP_UPDATE_OK;
  if (!success) {
    Serial.println("Update Failed: " + ESPhttpUpdate.getLastErrorString());
  }
#endif

  delete updateClient;

  return success;
}
