mlauke/smartswitch/smartswitch.espxx/include/app_icon.h

const char app_icon[] PROGMEM = { 0x00, 0x00, 0x01, 0x00, 0x01, 0x00, 0x20, 0x20, 0x10, 0x00, 0x01, 0x00, 0x04, 0x00, 0xE8, 0x02, 0x00, 0x00, 0x16, 0x00, 0x00, 0x00, 0x28, 0x00, 0x00, 0x00, 0x20, 0x00, 0x00, 0x00, 0x40, 0x00, 0x00, 0x00, 0x01, 0x00, 0x04, 0x00, 0x00, 0x00, 0x00, 0x00, 0x00, 0x00, 0x00, 0x00, 0x00, 0x00, 0x00, 0x00, 0x00, 0x00, 0x00, 0x00, 0x00, 0x00, 0x00, 0x00, 0x00, 0x00, 0x00, 0x00, 0x00, 0xAE, 0xDC, 0x00, 0x00, 0xA8, 0xF6, 0x00, 0x00, 0xB0, 0xF8, 0x00, 0x00, 0xB1, 0xF7, 0x00, 0x00, 0xB2, 0xF8, 0x00, 0x00, 0xB1, 0xFC, 0x00, 0x00, 0xB1, 0xFD, 0x00, 0x00, 0xB2, 0xFB, 0x00, 0x00, 0xB4, 0xF5, 0x00, 0x00, 0xB3, 0xFA, 0x00, 0x00, 0xB2, 0xFF, 0x00, 0x00, 0xB6, 0xFA, 0x00, 0x00, 0x00, 0x00, 0x00, 0x00, 0x00, 0x00, 0x00, 0x00, 0x00, 0x00, 0x00, 0x00, 0x00, 0x00, 0x00, 0xCC, 0xCC, 0xCC, 0xCC, 0xCC, 0xCC, 0xCC, 0xCC, 0xCC, 0xCC, 0xCC, 0xCC, 0xCC, 0xCC, 0xCC, 0xCC, 0xCC, 0xCC, 0xCC, 0xCC, 0xCC, 0xCC, 0xCC, 0xCC, 0xCC, 0xCC, 0xCC, 0xCC, 0xCC, 0xCC, 0xCC, 0xCC, 0xCC, 0xCC, 0xCC, 0xCC, 0xCC, 0xCC, 0xCC, 0xCC, 0xCC, 0xCC, 0xCC, 0xCC, 0xCC, 0xCC, 0xCC, 0xCC, 0xCC, 0xCC, 0xCC, 0xCC, 0xCC, 0xCC, 0xCC, 0xCC, 0x2C, 0xCC, 0xCC, 0xCC, 0xCC, 0xCC, 0xCC, 0xCC, 0xCC, 0xCC, 0xCC, 0xCC, 0xCC, 0xCC, 0xCC, 0xC4, 0xCC, 0xCC, 0xCC, 0xCC, 0xCC, 0xCC, 0xCC, 0xCC, 0xCC, 0xCC, 0xCC, 0xCC, 0xCC, 0x5C, 0xCC, 0x87, 0xBC, 0xCC, 0xCC, 0x8C, 0xCC, 0xCC, 0xCC, 0xCC, 0xCC, 0xCC, 0xCC, 0xCC, 0xC8, 0x79, 0xC5, 0x77, 0x7B, 0xC3, 0x97, 0xCC, 0xCC, 0xCC, 0xCC, 0xCC, 0xCC, 0xCC, 0xCC, 0xCC, 0xCC, 0x77, 0x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
