mlauke/smartswitch/smartswitch.espxx/include/LPB_LANG_de.h

#ifndef LPB_LANG_H
#define LPB_LANG_H

#define STR0_TEXT "Datum/Zeit"
#define STR1_TEXT "Uhrzeit"
#define STR2_TEXT "Tag/Monat"
#define STR3_TEXT "Jahr"

#define STR1610_TEXT "TWW Nennsollwert"
#define STR1612_TEXT "TWW Reduziertsollwert"
#define STR1614_TEXT "TWW Nennsollwert Maximum"
#define STR1615_TEXT "TWW Reduziertsollwert Minimum"
#define STR1645_TEXT "Legionellenfunktion Sollwert"

#define STR6224_TEXT "Geräte-Identifikation"
#define STR6225_TEXT "Gerätefamilie"
#define STR6226_TEXT "Gerätevariante"

#define STR8310_TEXT "Kesseltemperatur"

#define UNIT_DEG_TEXT "°C"

const char STR0[] = STR0_TEXT;
const char STR1[] = STR1_TEXT;
const char STR2[] = STR2_TEXT;
const char STR3[] = STR3_TEXT;

// Trinkwasser
const char STR1610[] = STR1610_TEXT;
const char STR1612[] = STR1612_TEXT;
const char STR1645[] = STR1645_TEXT;

// System
const char STR6224[] = STR6224_TEXT;
const char STR6225[] = STR6225_TEXT;
const char STR6226[] = STR6226_TEXT;

// Erzeuger
const char STR8310[] = STR8310_TEXT;

const char STR_UINT[] = "UINT";
const char STR_TEMP[] = "TEMP";
const char STR_UNKNOWN[] = "UNKNOWN";
const char STR_DATETIME[] = "DATETIME";
const char STR_STRING[] = "STRING";


const char U_DEG[] = UNIT_DEG_TEXT;
const char U_NONE[] = "";

#endif
