mlauke/smartswitch/(commit log)

2025-03-04 +fix: build +feat: pv settings
    [GithubOTA.h, index_html.h, smartswitch.esp8266.ino]
2025-03-04 +fix asset action +feat: gzip content
    [app_js.h, index_html.h, smartswitch.esp8266.ino]
2025-03-04 +fix: release tag update
    [GithubOTA.cpp, GithubOTA.h, smartswitch.esp8266.ino]
2025-03-05 +fix: NPE, status update
    [SmartSwitch.h, smartswitch.esp8266.ino]
2025-03-17 +feat: pv forecast +fix: js code
    [RestClient.cpp, RestClient.h, SmartSwitch.h, app_js.h, index_html.h, smartswitch.esp8266.ino]
2025-03-18 +feat: pv and battery forecast +feat: update ui
2025-03-18 +fix: min capacity update
    [index_html.h, smartswitch.esp8266.ino]
2025-03-19 +fix: return forecast 0 Wh if no solar forecast available +feature: ui update
    [SmartSwitch.h, app_js.h, index_html.h, smartswitch.esp8266.ino]
2025-03-19 fix: switch off if grid purchase is below threshold
    [SmartSwitch.h, smartswitch.esp8266.ino]
2025-03-19 +fix: grid feed in logic
    [SmartSwitch.h, smartswitch.esp8266.ino]
2025-03-19 +fix: gzip +fix: var names, clean code
    [RestClient.cpp, SmartSwitch.h, app_js.h, index_html.h, smartswitch.esp8266.ino]
2025-03-19 +fix: warning, adjust flash size
    [smartswitch.esp8266.ino]
2025-03-20 +fix: gzip compression, encoding
    [app_js.h, smartswitch.esp8266.ino]
2025-03-20 +fix: switch off on data error
    [RestClient.cpp, smartswitch.esp8266.ino]
2025-03-20 +fix: js retry on error
    [app_js.h]
2025-03-21 +feat: event log +fix: flicker, use penalty counter for inverter latency
    [SmartSwitch.h, app_css.h, app_js.h, index_html.h, smartswitch.esp8266.ino]
2025-03-21 +fix: dark mode event log style
    [app_css.h, index_html.h]
2025-03-25 +feat: layout update +feat: impr. event / error handling +feat: honor discharge not allowed state +feat: impr. update interval +fix: forecast calculation +fix: added panel declination +fix: inverter 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
    [RestClient.cpp, RestClient.h, SmartSwitch.h, app_css.h, app_js.h, index_html.h, smartswitch.esp8266.ino]
2025-03-25 +fix: ui and error message +feat: impr. forecast calculation
    [app_css.h, app_js.h, smartswitch.esp8266.ino]
2025-03-25 +feat: local time conversion +fix: inverter latency
    [SmartSwitch.h, app_css.h, app_js.h, index_html.h, smartswitch.esp8266.ino]
2025-03-25 +fix: event log timestamp handling +feat: localtime on server events
    [SmartSwitch.h, app_css.h, app_js.h, smartswitch.esp8266.ino]
2025-03-25 +fix: latency count +feat: delay update on error
    [RestClient.cpp, RestClient.h, SmartSwitch.h, app_css.h, app_js.h, index_html.h, smartswitch.esp8266.ino]
2025-03-25 +feat: switch on hysterese
2025-03-28 +fix: forecast min/max with hysterese
    [SmartSwitch.h, smartswitch.esp8266.ino]
2025-03-28 +fix: latency count flicker +fix: use local ts in msg
    [smartswitch.esp8266.ino]
2025-03-28 +fix: disabled if cons > max inverter power
    [smartswitch.esp8266.ino]
2025-03-28 +feat: ux/ui battery charge/discharge
2025-03-29 +fix: consumption if switched from on/auto mode +feat: update location from pv data
    [SmartSwitch.h, app_css.h, index_html.h, smartswitch.esp8266.ino]
2025-03-31 +fix: capacity update +feat: impr. ui
    [app_css.h, index_html.h, smartswitch.esp8266.ino]
2025-04-02 fix: switch on if bat cap > bat_cap min and surplus > load/2w fix: min capacity calculation "flicker" => use rounded avg
    [RestClient.cpp, SmartSwitch.h, smartswitch.esp8266.ino]
2025-04-06 +fix: use D7 for SSR +feat: layout update
    [SmartSwitch.h, app_css.h, index_html.h]
2025-04-15 +fix: check client connect during update
    [SmartSwitch.h, smartswitch.esp8266.ino]
2025-05-14 +fix: NPE in update handling and webserver client +feat: impr. UI, add boiler data
    [GithubOTA.cpp, GithubOTA.h, SmartSwitch.h, app_js.h, index_html.h, smartswitch.esp8266.ino]
2025-05-14 +fix: small layout changes
    [app_css.h]
2025-05-15 +fix: dev mode solarforecast +fix: layout
    [app_css.h, smartswitch.esp8266.ino]
2025-07-07 +feat: ui update +feat: device detect with retry
2025-07-07 +fix: wifi manager handling
    [smartswitch.esp8266.ino]
2025-07-10 +feat: esp32 support +feat: clean code
2025-07-10 +fix: build esp8266 binary
    [GithubOTA.h]
2025-07-13 +feat: more verbose, display constraint id in log +fix: runtime error with OTA
    [GithubOTA.cpp, LPB.cpp, RestClient.cpp, SmartSwitch.h, app_js.h, smartswitch.espxx.ino]
2025-07-13 +fix: skipped update will return last result
    [smartswitch.espxx.ino]
2025-07-13 +fix: enable ota begin
    [GithubOTA.cpp]
2025-07-27 +fix: workaround for esp32 OTA, can only deal with raw file (not gzip) +fix: various OTA update issues +fix: LPB retry and device handling
    [partitions.csv]
2025-08-07 +feat: impr. wifi reconnect +feat: impr. ui update, rm handleData call +fix: esp32/esp8266 built in led low/high issue
    [app_js.h, main.ino]
2025-09-02 +feat: impr. OTA with filter json
2025-09-13 +fix: fix event log +fix: hysteresis +feat: improve log message +feat: update doc
    [SmartSwitch.h, app_css.h, index_html.h, main.ino]
2025-09-14 +fix: low charge state detection
    [main.ino]
2025-09-18 +fix: load calibrate/update +fix: config data update handling
    [SmartSwitch.h, app_js.h, main.ino]
2025-09-21 +feat: start time +fix: impr. hysteresis
    [SmartSwitch.h, index_html.h, main.ino]
2025-09-21 +feat: load calibration
2025-09-21 +fix: calibrate
2025-09-21 +fix: load calibration
2025-09-22 +fix: impr. calibration calculation
    [SmartSwitch.h, index_html.h, main.ino]
2025-09-22 +fix: calibrate, use system data during switch on/off, more delay after toggle
    [SmartSwitch.h, index_html.h, main.ino]
2025-09-22 +fix: clean code, calibrate exactly
    [index_html.h, main.ino]
2025-09-23 +feat: impr. ui, asyn calibrate handling
2025-11-12 +fix: hysteresis in battery target +feat: clean code, unit tests +feat: impr. ux/ui
    [LPB.cpp, LPB.h, Logic.h, SmartSwitch.h, app_css.h, app_js.h, debug.h]
2025-11-13 +impr: esp8266 reduce heap, use flash string literals +fix: OTA handling
    [GithubOTA.cpp, RestClient.cpp, WiFiUtil.h, app_css.h, main.ino]
2025-11-14 +fix: double confirm in ui +impr: debug output handling +feat: use timezone offset from battery data
    [Logic.h, RestClient.cpp, RestClient.h, SmartSwitch.h, debug.h, index_html.h, main.ino]
2025-12-18 +fix: revision ota, espXX shared code +fix: layout ux/ui alignment +fix: http client handling +feat: enhance lpp init logic
    [partitions.csv]
2025-12-18 +fix: partition +fix: ota update and stream handling
    [partitions.csv]
2025-12-18 +fix: initial flashfs init and format +fix: hostname update
    [GithubOTA.cpp, index_html.h, main.ino]
2025-12-18 +fix: log message buffer
    [SmartSwitch.h, main.ino]
2025-12-19 +fix: esp8266 ota workaround
    [GithubOTA.cpp]
2025-12-19 +fix: esp8266 http workaround
    [GithubOTA.cpp, main.ino]
2025-12-19 +fix: patch buggy esp8266 ota
    [GithubOTA.cpp]
2025-12-22 +fix: round up load during calibrate
    [main.ino]
2025-12-28 +fix: forecast url dec, az interchanged +fix: always check overload constraint +feat: clean code
    [LPB.cpp, SmartSwitch.h, index_html.h, main.ino]
2026-01-05 +fix: constraint msg +feat: 3% from calibrated load
    [LPB.cpp, main.ino]
2026-01-14 +feat: cycle count +fix: workaround the full charge request (maintenance) +fix: battery data update every 4 hours +fix: clean code, variable namings
    [SmartSwitch.h, app_css.h, app_js.h, index_html.h, main.ino]
2026-01-14 +feat: impr. calibrate, use median +fix: load power 0 error +fix: security issue with api token
    [SmartSwitch.h, main.ino]
2026-01-16 +fix: inverter latency count
    [main.ino]
2026-01-18 +feat: battery usable capacity percentage +fix: clean code, message format
    [Logic.h, SmartSwitch.h, Util.h, app_css.h, index_html.h, main.ino]
2026-01-18 +fix: test, logic code
    [Logic.h, main.ino]
2026-01-18 +fix: percentage, test code
    [Logic.h, SmartSwitch.h, index_html.h, main.ino]
2026-01-18 +fix: compatibility to test
    [Logic.h]
2026-01-19 +feat: temperature with decimal precision 2
2026-01-20 +fix: surplus vs. battery goal flicker
    [Logic.h]
2026-01-21 +fix: cons under load
    [Logic.h, SmartSwitch.h, main.ino]
2026-01-21 +fix: esp32 target
2026-01-27 +fix: seg fault +feat: more verbose log message
    [LPB.cpp, Logic.h, SmartSwitch.h]
2026-02-02 +fix: flicker, switch off on system overload only
    [Logic.h, SmartSwitch.h]
2026-02-02 +fix: load hysteresis, adjust tests
    [Logic.h]
2026-02-03 +fix: fmt for int value
    [Logic.h, Util.h]
2026-02-03 +fix: surplus waste deactivated until valid state is available
    [Logic.h]
2026-02-06 +fix: esp32 hw serial lpb support
    [LPB.cpp, LPB.h, Logic.h, SmartSwitch.h, main.ino]
2026-02-11 +fix: npe +fix: name of lpb debug define
    [LPB.cpp]
2026-03-02 +fix: full charge request json +feat: impr. forecast with weight +feat: enable load if wasted surplus is greater then load +feat: fetch sonnen, use json filter +feat: impr. lpb findline, get rid of f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
    [LPB.cpp, LPB.h, Logic.h, SmartSwitch.h, Util.h, app_css.h, index_html.h, main.ino]
2026-03-04 +fix: forecast and trend indicator
    [Logic.h]
2026-03-04 +fix: enable load on positive trend with hysteresis
    [Logic.h, SmartSwitch.h]
2026-03-04 +fix: clean code, naming +fix: pull down for reliable state after reset
    [SmartSwitch.kicad_pcb, SmartSwitch.kicad_sch]
2026-03-05 +feat: more verbose +fix: hardening battery capacity trend
    [Logic.h]
2026-03-05 +fix: more hysteresis below min capacity
    [SmartSwitch.h]
2026-03-06 +feat: device details
2026-03-08 +feat: do switch control although no pv forecast data available - e-g- surplus waste
2026-03-08 +feat: skip desired state if mode not set to auto
    [main.ino]
2026-03-08 +feat: docu, kicad
2026-03-08 +fix: low capacity switch off
    [Logic.h, SmartSwitch.h, main.ino]
2026-03-13 +fix: final capacity below min wont switch on
    [Logic.h]
2026-03-17 +fix: balanced below min usoc +fix: clean kicad pcb
    [SmartSwitch.kicad_pcb]
2026-03-18 fix: calibrate button/spinner layout bug
    [app_css.h, app_js.h, index_html.h]
2026-03-20 +feat: invalid data error cause +fix: ux/ui overlay
    [Logic.h, SmartSwitch.h, app_css.h, index_html.h, main.ino]
2026-03-20 +fix: event log buffer
    [main.ino]
2026-03-20 +fix: calculate battery capacity with consumption in wh
    [Logic.h, SmartSwitch.h, app_js.h, index_html.h]
2026-03-20 +fix: formatting, more tests
    [Logic.h, Util.h]
2026-03-23 +fix: log overlay layout +fix: clean code
    [Logic.h, app_css.h, app_js.h, index_html.h]
2026-03-23 +fix: overlay empty log
    [app_css.h]
2026-03-23 +fix: clean code, pstr
    [GithubOTA.cpp, Logic.h, RestClient.cpp, RestClient.h, SmartSwitch.h, app_css.h, main.ino]
2026-03-25 +fix: ramining hours label
    [Logic.h]
2026-03-29 fix: correct critical bugs found in code review
    - LPB.cpp: fix assignment-instead-of-comparison (type = 0x14 → type == 0x14)
    in response matching condition
    - LPB.cpp: fix NaN temperature check (== NAN → isnan()) — IEEE 754 makes
    == NAN always false, causing failed reads to silently propagate
    - Logic.h: fix off-by-one in findPvForecastData loop (i <= → i <
    SOLAR_FORECAST_HOURS) preventing out-of-bounds array access
    - main.ino: fix strncpy missing null terminator in putLog → snprintf
    - main.ino: fix division by zero when cap_bat_new_Wh is 0
    - main.ino: fix negative UTC offset lost by uint8_t cast → int16_t
    - Logic.h: reset inverterLatencyCnt in setUp() to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
    [LPB.cpp, LPB.h, Logic.h, SmartSwitch.h, Util.h, app_css.h, index_html.h, main.ino]
2026-03-30 +feat: consumption stats bar chart overlay with y/x axis
    - Add cons_stats_Wh[7][24] EMA tracking (α=0.1) per weekday×hour in Logic.h
    - Persist stats to flash hourly (no version bump) via saveConfig(false)
    - Reset stats on location change
    - Use per-hour stats in predictBatteryCapacityState() with fallback to cons_W_norm
    - Expose cons_stats nested array in /api/data JSON response
    - Frontend: bar chart overlay triggered from Consumption row (Stats link)
    - 24 CSS flex bars normalized to global max across all 7 days
    - Y-axis scale (max/mid/0 Wh), X-axis hour labels (0,6,12,18) below bars
    - Day selector buttons (Sun–Sat), current hour highlighted green
    - Dark mode support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
    [Logic.h, SmartSwitch.h, app_css.h, app_js.h, index_html.h, main.ino]
2026-03-30 fix: replace per-tick EMA with true hourly mean for consumption stats
    EMA applied every 2s caused the stored value to reflect only the last
    ~20 seconds of the hour rather than a real hourly average. Fix
    accumulates samples within the hour (sum + count), computes the
    arithmetic mean on hour rollover, then blends it into the historical
    slot via cross-week EMA α=0.1.
    Adds cons_sum_W / cons_count transient fields to SystemState.
    [Logic.h, SmartSwitch.h, WiFiUtil.h, app_css.h, index_html.h, main.ino]
2026-03-30 +feat: max cap Wh to battery +feat: bump version also on stats update
2026-03-31 +feat: also display current hour mean
2026-04-01 +fix: hourly stats become invalid if battery is not reachable, sanity check added
    [Logic.h, SmartSwitch.h, app_js.h, main.ino]
2026-04-01 +fix: cons_avg override from battery +fix: do not reset cons average on hourly rollover
    [Logic.h, SmartSwitch.h, main.ino]
2026-04-02 +fix: ui, consider consumption avg. max value in statistics
    [Logic.h, app_js.h]
2026-04-09 +feat: impr. ui stats, determine max value from forecast and consumption to draw y axis +fix: bug: flicker when SoC 0% +fix: bug: flicker when consumption without load is very low
    [Logic.h, SmartSwitch.h, app_js.h, main.ino]
2026-05-11 +feat: reset statistic on location update
    [index_html.h, main.ino]
2026-06-13 +fix: switch on if waste exceeds load and battery will full charge anyway, although usoc is 0
    [Logic.h, SmartSwitch.h]
2026-06-15 +fix: battery fully charged or will full charge (max) but no surplus is available
    [Logic.h]
2026-06-15 +feat: test battery full charged and forecast state Max
2026-08-19 +fix: new api key UTC_Offset +feat: state pattern
    [Logic.h, SmartSwitch.h, main.ino]
2026-08-19 +feat: clean code, use const. more verbose on OTA update error
    [GithubOTA.cpp, GithubOTA.h]
2026-09-06 +fix: impr. status handling, loop code +feat: esp32 watchdog
    [LPB.cpp, LPB.h, SmartSwitch.h, main.ino]
2026-09-23 +feat: trace wifi restart
2026-09-25 +fix: event log file creation
    [main.ino]
